naubiomech/OpenExo/README.md

# Teensy Nano Board

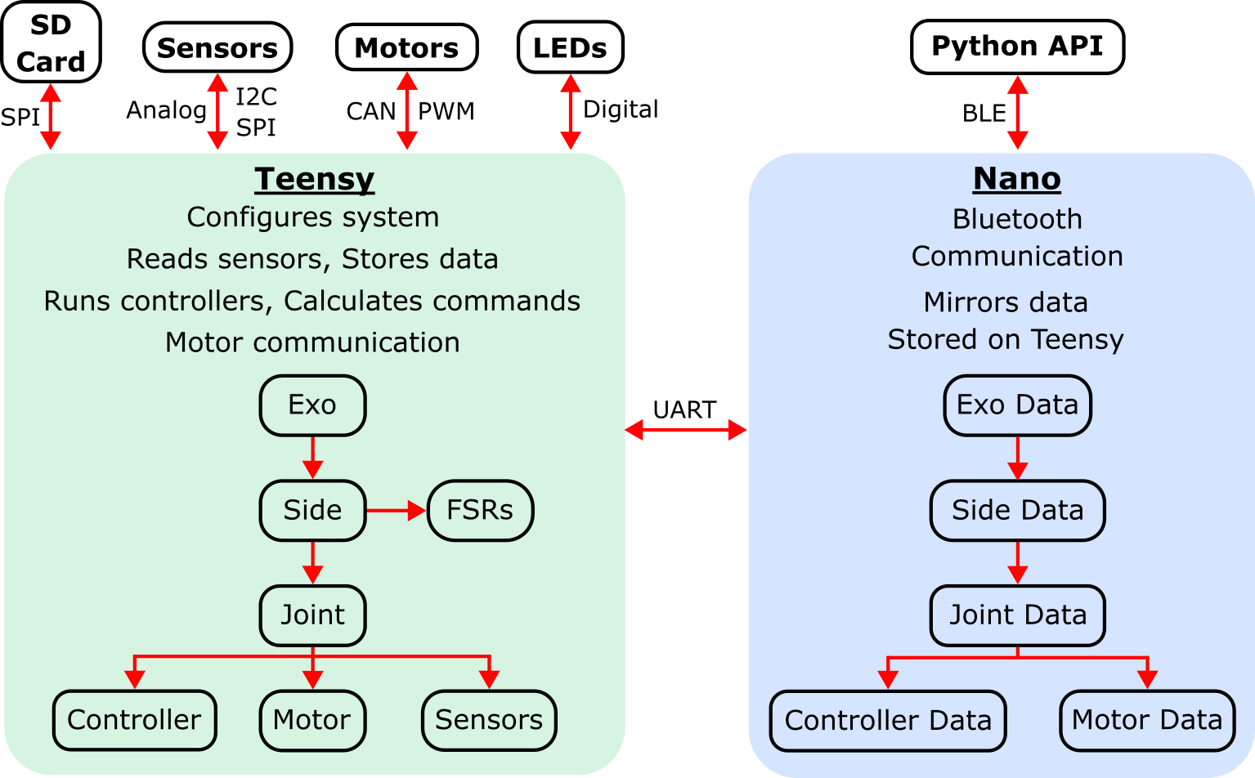
[picture p1: Documentation/Figures/Code_Structure.png]
Diagram


This code uses two microcontrollers to control wearable robots. In order to
build the and flash the codebase check [here](Documentation/BUILD_AND_FLASH.md) and [here](https://github.com/naubiomech/TeensyNanoExoCode/blob/main/Documentation/README.md#how-to-deploy). If you would like to
contribute check [here](CONTRIBUTING.md) for more details. 
 
Check out the [Documentation Folder](/Documentation) for more details and C++ info.

Documentation on the software can be found on our [read the docs page](https://theopenexo.readthedocs.io/en/latest/index.html).

Documentation on the hardware can be found on our [wiki](https://wiki.theopenexo.org).

Video walkthroughs on getting started and indepth looks at different aspects of the system can be found on the OpenExo [YouTube page](https://www.youtube.com/@TheOpenExo).
