naubiomech/OpenExo/Andriod_App/FinalProject_Part1_Documentation.pdf

Final Project - Part 1

April 7, 2026

Group Members:

Landon Coonrod: Lead Developer (UI/UX design, navigation, Firebase REST API integration, database design, documentation, and architectural decisions)
AI Assistant: Assists with BLE Bluetooth communication, real-time charting,
CSV file handling

Physical Phone Availability:
No, our group needs access to a physical Android phone for testing.

REST API:
We are using Firebase Authentication REST API and Firebase Realtime Database REST API. Firebase Auth handles user login/signup so researchers can have their own accounts and keep their trial data separate. Firebase Realtime Database stores trial logs, settings,
and notes in the cloud so data can be accessed from multiple devices. We chose Firebase because it has a free tier and works well with Android.

I am using AI as my second team member. I handle everything covered in class
(UI screens, REST API integration, database design, MVVM architecture, documentation, UML diagrams). AI assists with the stuff not covered in class like BLE hardware communication, real-time data charting, and CSV export.

Basic UI:
The app has 6 screens:
1. Login Screen: Email/password login and signup screen using Firebase Auth. Has input fields, show/hide password toggle, error messages, and a toggle between login and create account modes.

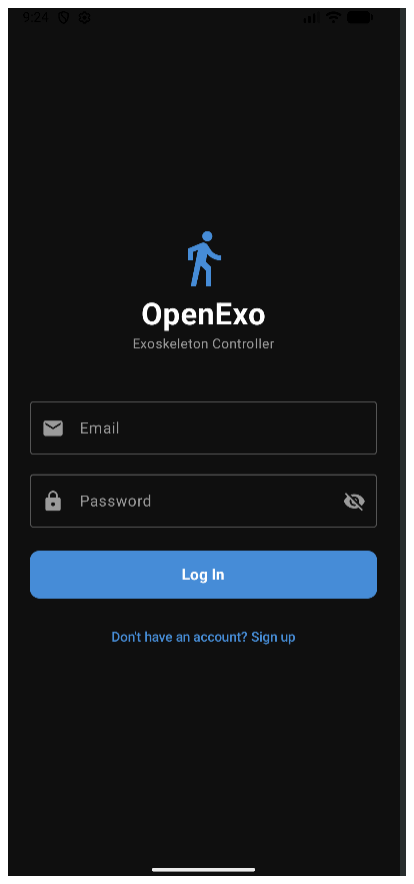
[picture p25: figure]

2. Scan Screen: Home screen where users scan for and connect to OpenExo devices via bluetooth. Has connection status indicator, device list, and buttons for scanning, connecting, calibrating torque, and starting a trial.

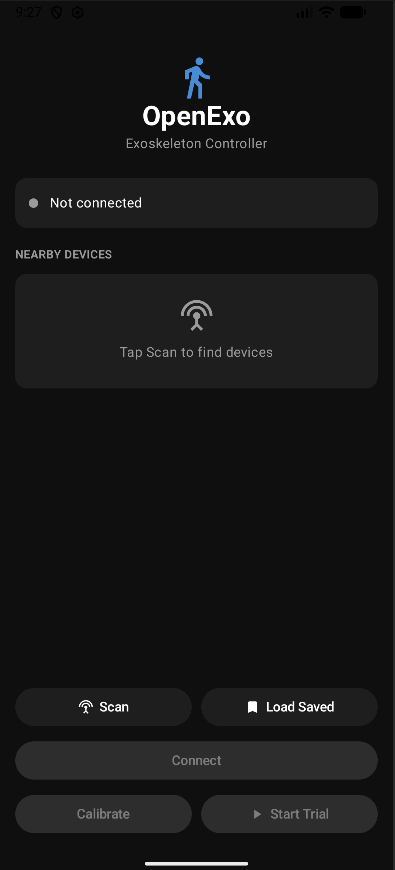
[picture p26: figure]

3. Active Trial Screen: Main trial view with real-time chart placeholders for torque and angle data, battery voltage display, pause/resume and end trial controls, and a list of controller actions like marking trials and updating settings.

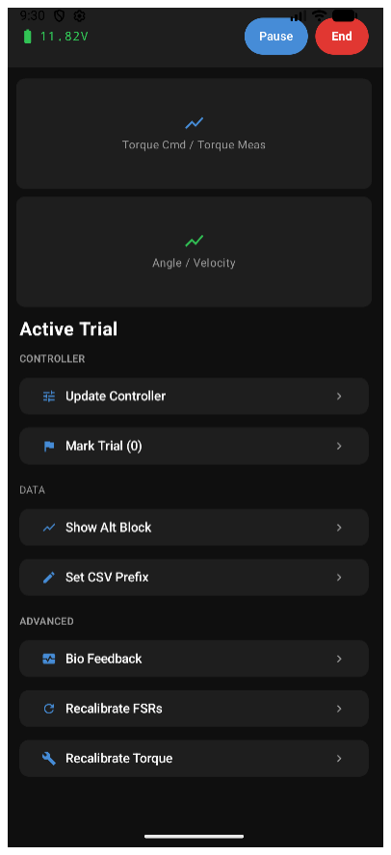
[picture p27: figure]

4. Settings Screen: Controller parameter configuration with an advanced/basic toggle, joint selector dropdown, controller radio buttons, and a numeric value input field
with cancel/apply buttons.

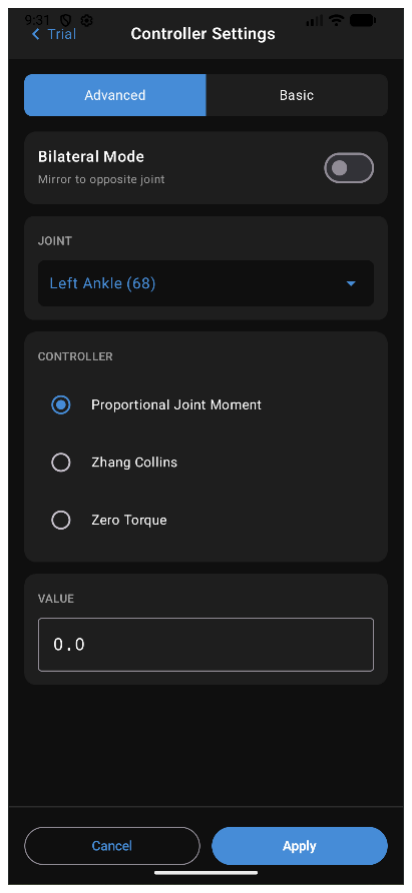
[picture p28: figure]

5. Biofeedback Screen: Displays FSR sensor readings with a large numeric readout, targets reached counter, chart placeholder for real-time FSR signal, target threshold display, leg toggle, and FSR index configuration.

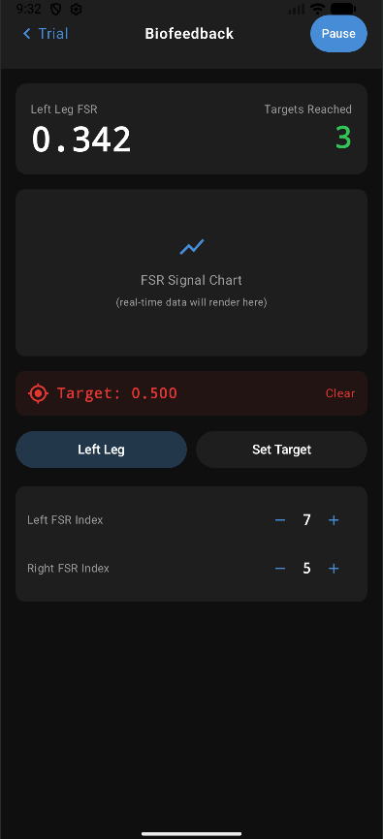
[picture p29: figure]

6. End Trial Screen: Post-trial review screen showing file details (name, size, data points, duration), rename field, trial notes text area, share/export option, and save or discard buttons.

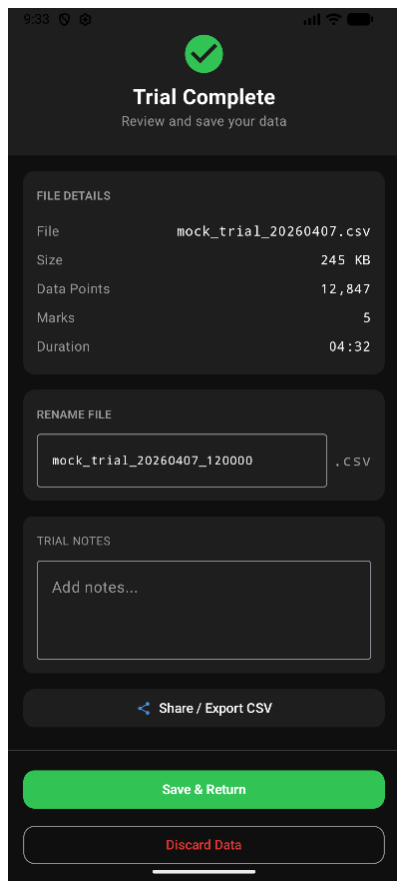
[picture p30: figure]

Tech Stack:
- Kotlin + Jetpack Compose
- Navigation Compose for screen routing
- Material 3 / Material Icons
- Dark theme throughout the app
