naubiomech/OpenExo/Documentation/ReadTheDocs/source/introduction.rst

Introduction
============

Welcome to the OpenExo Software Documentation! This documentation serves as a comprehensive guide to the OpenExo firmware.

Key topics covered in this documentation include:

- `User Guide <https://theopenexo.readthedocs.io/en/latest/User_Guide.html>`__: A concise overview of the coding standards and engineering principles our group follows.
- `First Time Startup <https://theopenexo.readthedocs.io/en/latest/FirstTimeStartup.html>`__: Guide to starting up the exoskeleton and running a controller for the first time. 
- `Installation <https://theopenexo.readthedocs.io/en/latest/installation.html>`__: Step-by-step guidance to set up the software and hardware components.
- `Adding Elements <https://theopenexo.readthedocs.io/en/latest/addingelements.html>`__: Practical examples that show how to extend the platform with new sensors, actuators, and algorithms.
- `Controllers <https://theopenexo.readthedocs.io/en/latest/controllers.html>`__: Reference material and tutorials for implementing ankle and elbow controllers.
- `OpenExo GUI <https://theopenexo.readthedocs.io/en/latest/gui.html>`__:  A walkthrough of our Python-based graphical application for configuring and controlling the exoskeleton.
- `Gamification Template <https://theopenexo.readthedocs.io/en/latest/gamification_template.html>`__: Guidelines and assets for a biofeedback gamification option.
- `Style Guide <https://theopenexo.readthedocs.io/en/latest/StyleGuide.html>`__: Overview of how we maintain our firmware. 
- `Documentation <https://theopenexo.readthedocs.io/en/latest/AddingNewPages.html>`__: Instructions for adding pages, diagrams, and API references to the Read the Docs site

Whether you're a engineer, clinician, or a curious global citizen, we hope this resource helps you explore, learn, and contribute to advancing wearable robotics and rehabilitation technologies.
