naubiomech/OpenExo/Andriod_App/screenshots/active.png

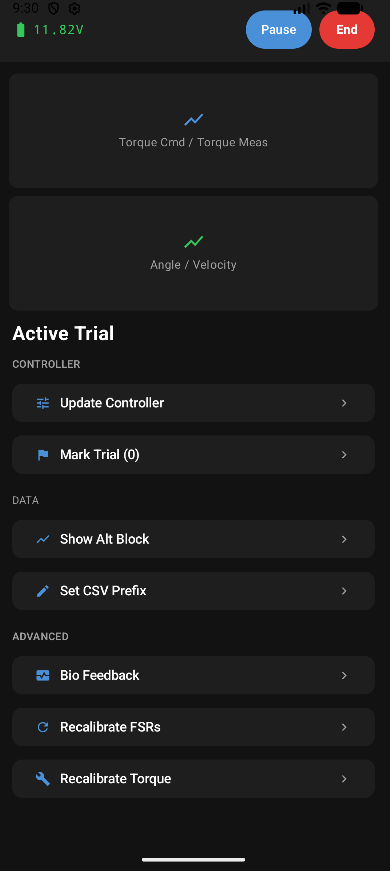
Andriod_App/screenshots/active.png
