naubiomech/OpenExo/Andriod_App/screenshots/endtrial.png

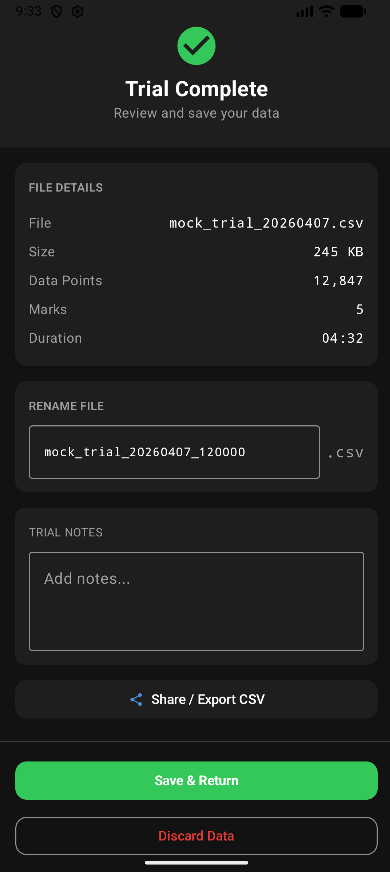
Andriod_App/screenshots/endtrial.png
