naubiomech/OpenExo/Andriod_App/screenshots/login.png

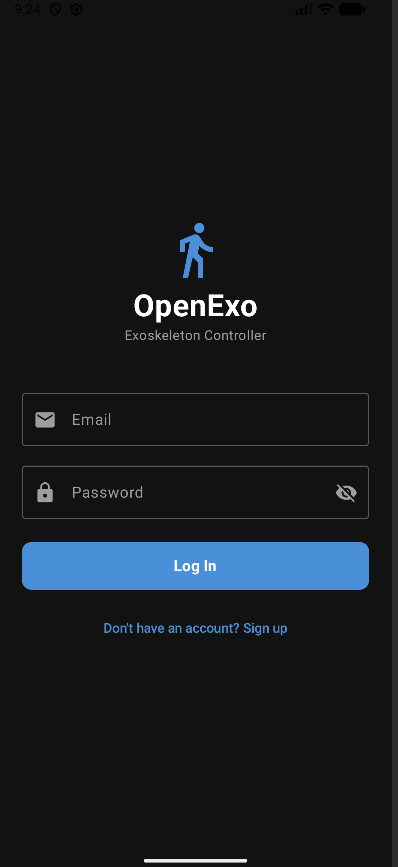
Andriod_App/screenshots/login.png
