naubiomech/OpenExo/Andriod_App/screenshots/settings.png

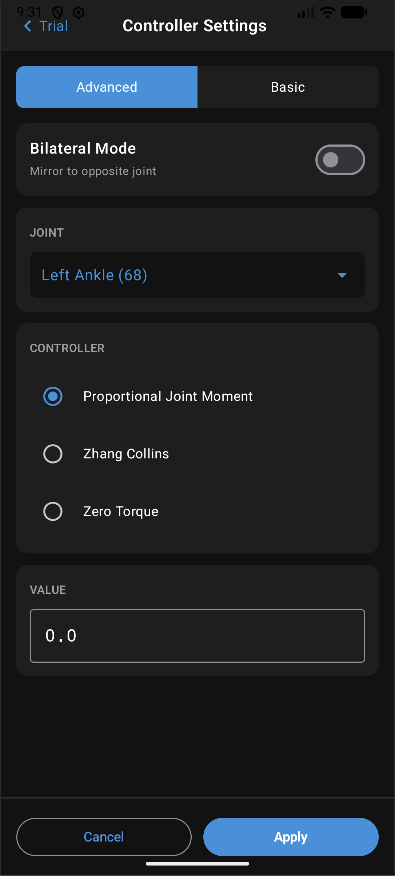
Andriod_App/screenshots/settings.png
