naubiomech/OpenExo/Python_GUI/Resources/Images/OpenExo.png

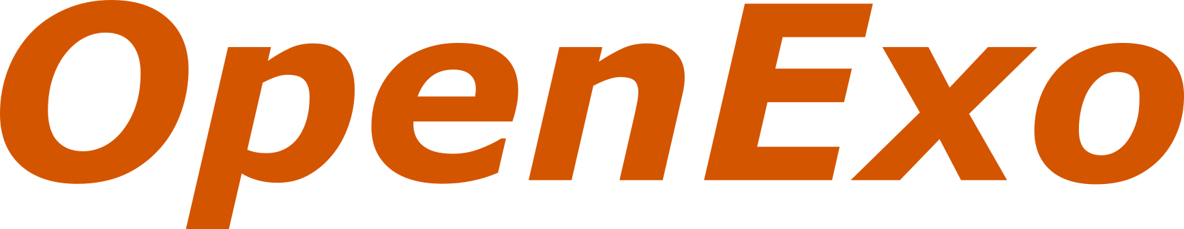
Python_GUI/Resources/Images/OpenExo.png
