naubiomech/OpenExo/Python_GUI/Resources/Images/pause.png

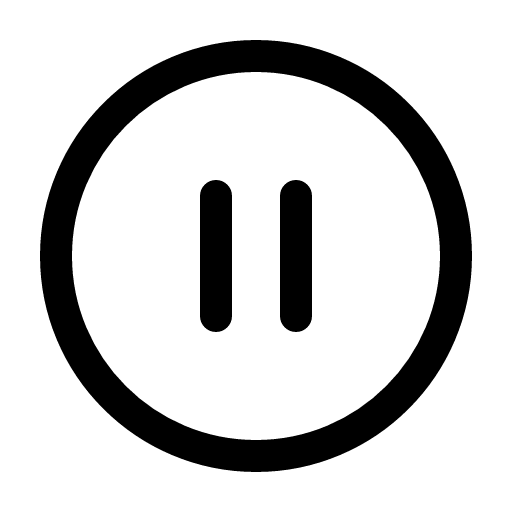
Python_GUI/Resources/Images/pause.png
