naubiomech/OpenExo/Python_GUI/Resources/Images/play.png

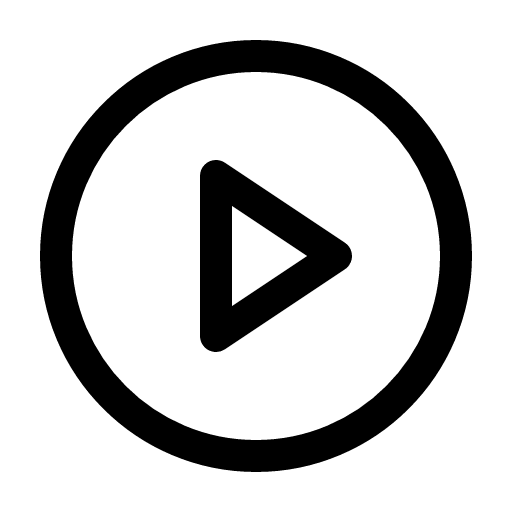
Python_GUI/Resources/Images/play.png
