naubiomech/OpenExo/Hardware/Bowden_Transmission/Large_Cable/Universal Cable Chain Interface/UCCI.STEP

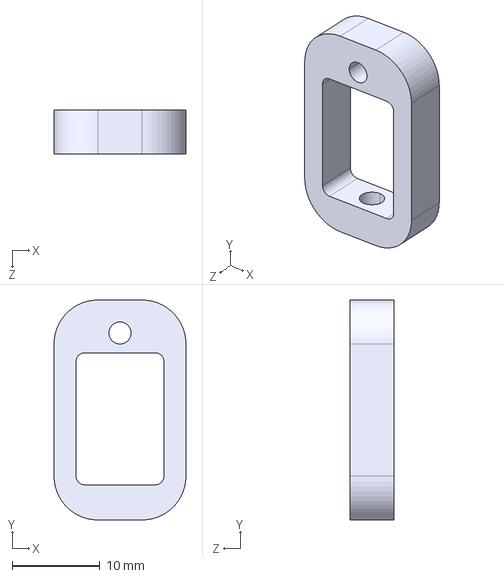
[picture p38: CAD file, 2024-09-13, last stored version]
Hardware/Bowden_Transmission/Large_Cable/Universal Cable Chain Interface/UCCI.STEP
15.0 x 25.0 x 5.00 mm
