naubiomech/OpenExo/Hardware/Bowden_Transmission/Parts/AK60V1.1/3D_Printed_Parts/Heat_Shield (Optional)/ak60v1_1HeatShield.SLDPRT

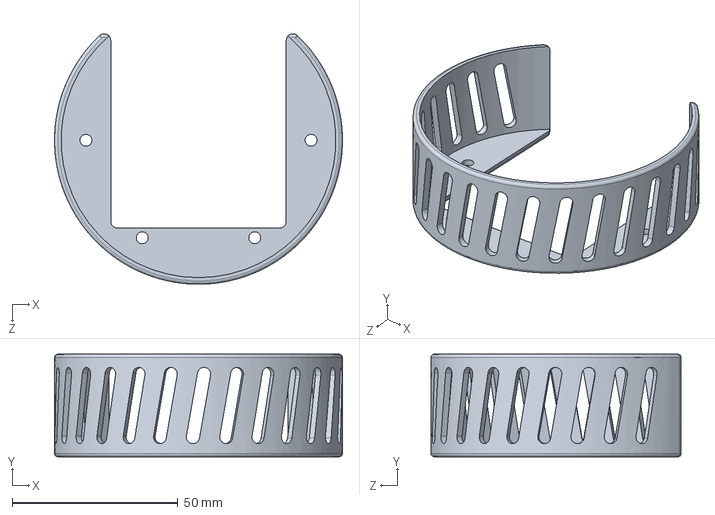
[picture p39: CAD file, 2025-01-06, last stored version]
Hardware/Bowden_Transmission/Parts/AK60V1.1/3D_Printed_Parts/Heat_Shield (Optional)/ak60v1_1HeatShield.SLDPRT
87.0 x 31.0 x 75.7 mm
