naubiomech/OpenExo/Hardware/Bowden_Transmission/Parts/AK60V1.1/3D_Printed_Parts/Strain_Relief_Inserts_TPU.SLDPRT

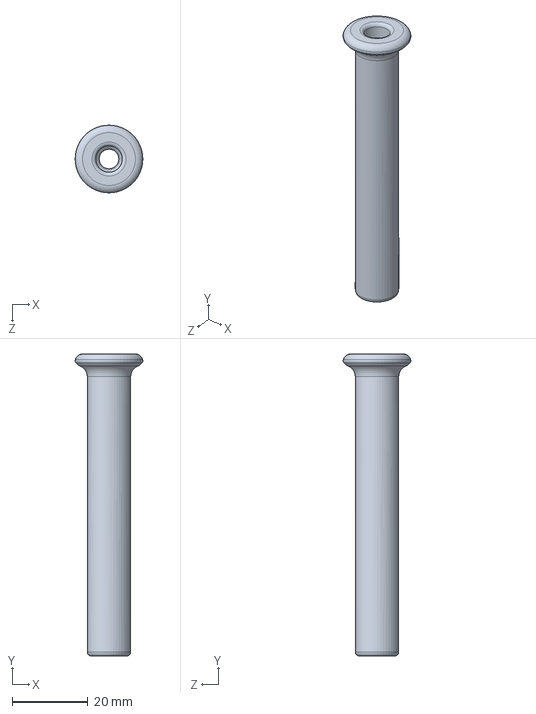
[picture p40: CAD file, 2024-09-13, last stored version]
Hardware/Bowden_Transmission/Parts/AK60V1.1/3D_Printed_Parts/Strain_Relief_Inserts_TPU.SLDPRT
17.9 x 80.0 x 17.9 mm
