naubiomech/OpenExo/Hardware/Bowden_Transmission/Parts/AK60V1.1/Machined_Parts/Sprocket_AK60V1_1.SLDPRT

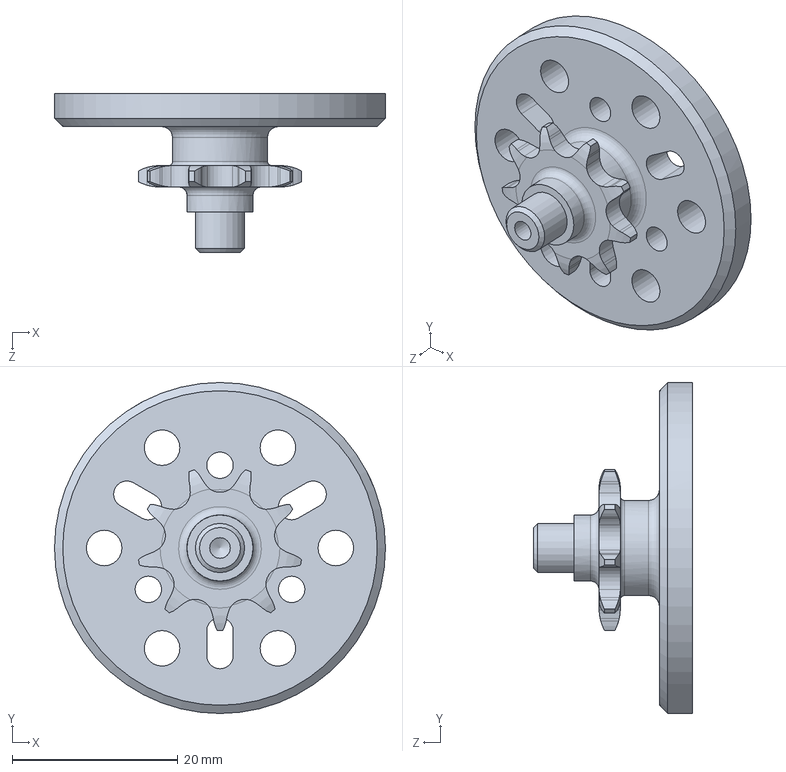
[picture p41: CAD file, 2024-09-13, last stored version]
Hardware/Bowden_Transmission/Parts/AK60V1.1/Machined_Parts/Sprocket_AK60V1_1.SLDPRT
40.0 x 40.0 x 19.2 mm
