naubiomech/OpenExo/Hardware/Bowden_Transmission/Parts/AK80/3D_Printed_Parts/Heat_Shield (Optional)/ak80HeatShield.SLDPRT

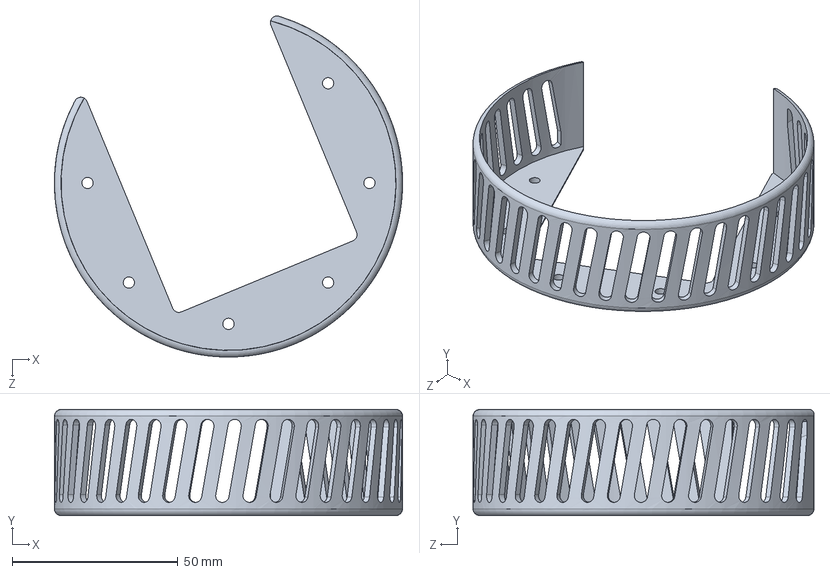
[picture p42: CAD file, 2025-01-06, last stored version]
Hardware/Bowden_Transmission/Parts/AK80/3D_Printed_Parts/Heat_Shield (Optional)/ak80HeatShield.SLDPRT
105.0 x 32.0 x 102.8 mm
