naubiomech/OpenExo/Hardware/Hip_Device/Part Files for 3D Printing/Heat_Shield (Optional)/hipHeatShield.SLDPRT

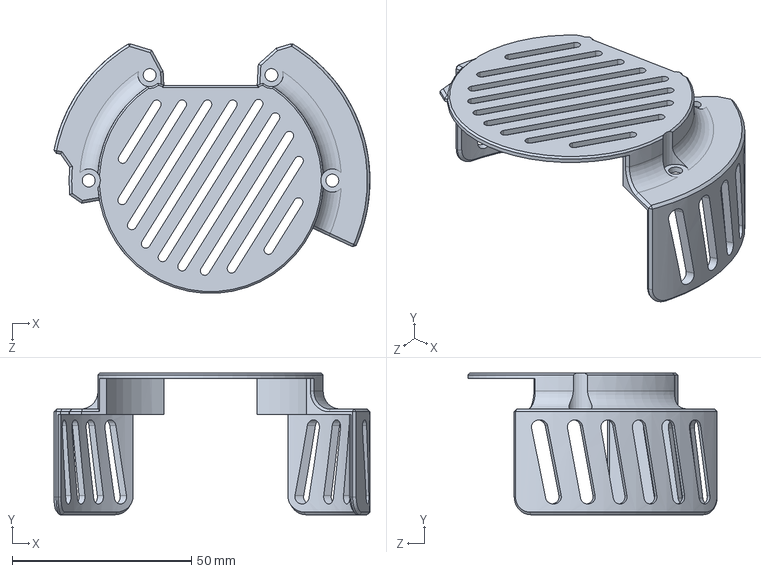
[picture p43: CAD file, 2025-01-06, last stored version]
Hardware/Hip_Device/Part Files for 3D Printing/Heat_Shield (Optional)/hipHeatShield.SLDPRT
88.2 x 39.5 x 69.6 mm
