naubiomech/OpenExo/Hardware/Bowden_Transmission/Parts/AK60V1.1/3D_Printed_Parts/Back_Cover_AK60V1_1(1).SLDPRT

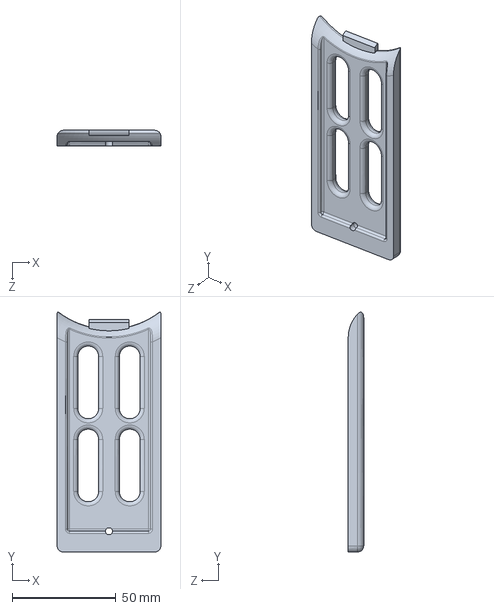
[picture p44: CAD file, 2024-09-13, last stored version]
Hardware/Bowden_Transmission/Parts/AK60V1.1/3D_Printed_Parts/Back_Cover_AK60V1_1(1).SLDPRT
50.0 x 115.7 x 7.50 mm
