naubiomech/OpenExo/(list of files, cad)

Other CAD files:
Hardware/Bowden_Transmission/Large_Cable/Universal Cable Chain Interface/UCCI.SLDDRW
Hardware/Bowden_Transmission/Large_Cable/Universal Cable Chain Interface/UCCI.SLDPRT
Hardware/Bowden_Transmission/Large_Cable/Universal Cable Chain Interface/UCCI.STL
