naubiomech/OpenExo/SDCard/elbowControllers/step.csv

5 | header Size, the first N rows will be ignored, except for this first cells in the first two rows
9 | parameter number, the number of parameters to read per line
 | Parameter list for the Sine controller
 | Parameter order:
Amplitude | Duration | Repetitions | Spacing | PID Flag | P Gain | I Gain | D Gain | Alpha
0 | 0 | 0 | 0 | 0 | 0 | 0 | 0 | 100
