naubiomech/OpenExo/Documentation/ReadTheDocs/source/installation.rst

Installation
============

Overview of the installation process.

.. toctree::
   :maxdepth: 2
   :caption: Installation Subcategories:

   vscode_setup
   BuildAndFlash
