naubiomech/OpenExo/Documentation/ReadTheDocs/source/photos/StartupGuide/BoardsManager.png

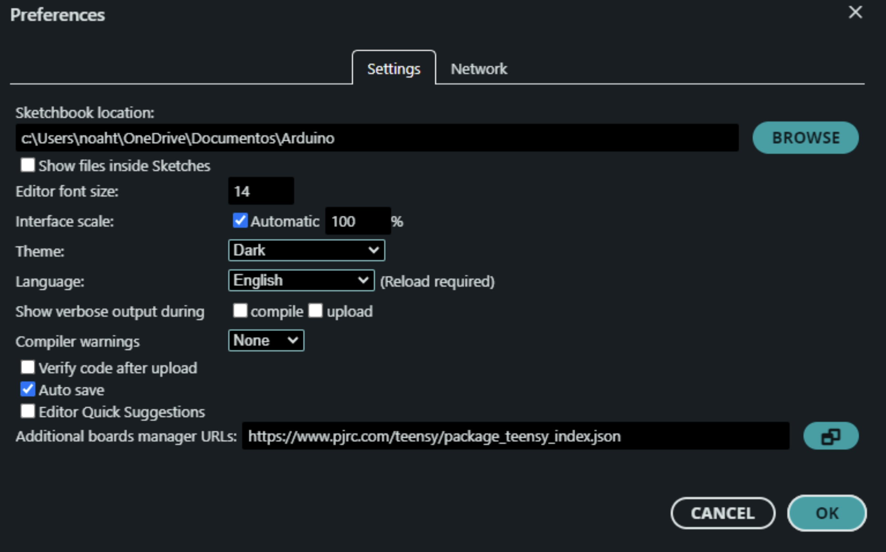
Documentation/ReadTheDocs/source/photos/StartupGuide/BoardsManager.png
