naubiomech/OpenExo/ExoCode/src/Controller.cpp

/*
 * P. Stegall Jan. 2022
*/

#include "Controller.h"
#include "Logger.h"
//#define CONTROLLER_DEBUG          //Uncomment to enable debug statements to be printed to the serial monitor

//Arduino compiles everything in the src folder even if not included so it causes and error for the nano if this is not included.
#if defined(ARDUINO_TEENSY36)  || defined(ARDUINO_TEENSY41) 
#include <math.h>
#include <random>
#include <cmath>

_Controller::_Controller(config_defs::joint_id id, ExoData* exo_data)
{
    _id = id;
    _data = exo_data;
    
    _t_helper = Time_Helper::get_instance();
    _t_helper_context = _t_helper->generate_new_context();
    _t_helper_delta_t = 0;
    _sim_gait_context = _t_helper->generate_new_context();
    _sim_elapsed_us = 0.0f;
    
    //We just need to know the side to point at the right data location so it is only for the constructor
    bool is_left = utils::get_is_left(_id);
    
    #ifdef CONTROLLER_DEBUG
        logger::print(is_left ? "Left " : "Right ");
    #endif 

    _prev_input = 0; 
    _prev_de_dt = 0;
        
    //Set _controller_data to point to the data specific to the controller.
    switch (utils::get_joint_type(_id))
    {
        case (uint8_t)config_defs::joint_id::hip:
            #ifdef CONTROLLER_DEBUG
                logger::print("HIP ");
            #endif
            if (is_left)
            {
                _controller_data = &(exo_data->left_side.hip.controller);
                _joint_data = &(exo_data->left_side.hip);
            }
            else
            {
                _controller_data = &(exo_data->right_side.hip.controller);
                _joint_data = &(exo_data->right_side.hip);
            }
            break;
            
        case (uint8_t)config_defs::joint_id::knee:
            #ifdef CONTROLLER_DEBUG
                logger::print("KNEE ");
            #endif
            if (is_left)
            {
                _controller_data = &(exo_data->left_side.knee.controller);
                _joint_data = &(exo_data->left_side.knee);
            }
            else
            {
                _controller_data = &(exo_data->right_side.knee.controller);
                _joint_data = &(exo_data->right_side.knee);
            }
            break;
        
        case (uint8_t)config_defs::joint_id::ankle:
            #ifdef CONTROLLER_DEBUG
                logger::print("ANKLE ");
            #endif
            if (is_left)
            {
                _controller_data = &(exo_data->left_side.ankle.controller);
                _joint_data = &(exo_data->left_side.ankle);
            }
            else
            {
                _controller_data = &(exo_data->right_side.ankle.controller);
                _joint_data = &(exo_data->right_side.ankle);
            }
            break;
        case (uint8_t)config_defs::joint_id::elbow:
            #ifdef CONTROLLER_DEBUG
                        logger::print("ELBOW ");
            #endif
            if (is_left)
            {
                _controller_data = &(exo_data->left_side.elbow.controller);
                _joint_data = &(exo_data->left_side.elbow);
            }
            else
            {
                _controller_data = &(exo_data->right_side.elbow.controller);
                _joint_data = &(exo_data->right_side.elbow);
            }
            break;
        case (uint8_t)config_defs::joint_id::arm_1:
            #ifdef CONTROLLER_DEBUG
                logger::print("ARM 1 ");
            #endif
            if (is_left)
            {
                _controller_data = &(exo_data->left_side.arm_1.controller);
                _joint_data = &(exo_data->left_side.arm_1);
            }
            else
            {
                _controller_data = &(exo_data->right_side.arm_1.controller);
                _joint_data = &(exo_data->right_side.arm_1);
            }
            break;
        case (uint8_t)config_defs::joint_id::arm_2:
            #ifdef CONTROLLER_DEBUG
                logger::print("ARM 2 ");
            #endif
            if (is_left)
            {
                _controller_data = &(exo_data->left_side.arm_2.controller);
                _joint_data = &(exo_data->left_side.arm_2);
            }
            else
            {
                _controller_data = &(exo_data->right_side.arm_2.controller);
                _joint_data = &(exo_data->right_side.arm_2);
            }
            break;
    }

    #ifdef CONTROLLER_DEBUG
        logger::print("Controller : \n\t_controller_data set \n\t_joint_data set");
    #endif

    //Added a pointer to the side data as most controllers will need to access info specific to their side.
    if (is_left)
    {
        _side_data = &(exo_data->left_side);
    }
    else
    {
        _side_data = &(exo_data->right_side);
    } 

    #ifdef CONTROLLER_DEBUG
        logger::println("\n\t_side_data set");
    #endif
    
    //Set the parameters for cf mfac
    measurements.first = -1;
    measurements.second = 1;
    outputs.first = 0;
    outputs.second = 0;
    phi.first = 2;
    phi.second = 0;
    rho = 0.5;
    lamda = 2;
    etta = 1;
    mu = 1;
    upsilon = 1 / (pow(10, 5));
    phi_1 = phi.first;
}

//****************************************************

void _Controller::reset_integral()
{
    _pid_error_sum = 0;
    _prev_input = 0;
    _prev_de_dt = 0;
    _prev_pid_time = 0;
}

//****************************************************

float _Controller::_cf_mfac(float reference, float current_measurement)         //Compact Form Model Free Adaptive Controller (In-development, not yet employed)
{
    //Calculate k-1 (k_0) delta
    const float du_k0 = outputs.second - outputs.first;

    //Prime the state
    measurements.first = measurements.second;
    outputs.first = outputs.second;
    phi.first = phi.second;
    measurements.second = current_measurement;

    //Calculate k delta
    const float dy_k = measurements.second - measurements.first;

    //Calculate the new psuedo partial derivative
    const float phi_numerator = etta * du_k0 * (dy_k - (phi.first*du_k0));
    const float phi_denominator = mu + (du_k0*du_k0);
    phi.second = phi.first + (phi_numerator/phi_denominator);

    //Calculate the new output
    const float error = reference - measurements.second;
    const float u_numerator = rho * phi.second * error;
    const float u_denominator = lamda + (abs(phi.second) * abs(phi.second));
    outputs.second = outputs.first + (u_numerator/u_denominator);
    return outputs.second;
}

//****************************************************
 
float _Controller::_pid(float cmd, float measurement, float p_gain, float i_gain, float d_gain)
{	
	// Disable pid for torque control if the torque sensor isn't calibrated
	if (_joint_data->torque_offset_reading == 0) {
		Serial.print("\nTorque sensor not calibrated. Closed-loop torque control disabled.");
		return cmd;
	}
    const float expected_us = (1.0f / LOOP_FREQ_HZ) * 1000000.0f;
    const float dt_us = _t_helper->tick(_t_helper_context);
    const bool time_good = (dt_us > 0.0f) && (dt_us <= expected_us * (1.0f + LOOP_TIME_TOLERANCE));
    const float dt_s = dt_us / 1000000.0f;

    //Calculate the difference in the prescribed and measured torque 
    float error_val = cmd - measurement;  

    //If we want to to include the integral term (Note: We generally do not like to use the I gain but we have it here for completeness) 
    if (i_gain != 0)
    {
        if (time_good)
        {
            _pid_error_sum += error_val * dt_s;
        }
    }
    else
    {
        _pid_error_sum = 0;
    }

    //Get the current status of the exskleton 
    uint16_t exo_status = _data->get_status();
    bool active_trial = (exo_status == status_defs::messages::trial_on) || (exo_status == status_defs::messages::fsr_calibration) || (exo_status == status_defs::messages::fsr_refinement);

    //Reset the integral term if the user pauses the trial or we are no longer in an active trial
    if (_data->user_paused || !active_trial)
    {
        _pid_error_sum = 0;
    }

    //Initialize the derivative of the error 
    float de_dt = 0;

    //Calculate the derivative of the error
    if (time_good && dt_s > 0.0f)
    {
        de_dt = -(measurement - _prev_input) / dt_s;
        _prev_de_dt = de_dt;
    }
    else 
    {
        de_dt = 0;
    }

    //Set the previous times for the next loop through the controller
    _prev_input = measurement;

    //Calculate the individual P,I,and D Terms
    float p = p_gain * error_val;  
    float i = i_gain * _pid_error_sum; 
    float d = d_gain * de_dt; 

    //Return the summed PID
    return p + i + d;

}

//****************************************************

float _Controller::_get_percent_gait(bool simulate)
{
    if (!simulate)
    {
        return _side_data->percent_stance;
    }

    _sim_elapsed_us += _t_helper->tick(_sim_gait_context);
    return fmodf(_sim_elapsed_us, 1000000.0f) / 1000000.0f * 100.0f;
}

//****************************************************
 
float _Controller::_pjmc_generic(float current_fsr, float fsr_threshold, float setpoint_positive, float setpoint_negative)
{
	if (fsr_threshold == 1)
    {
		return 0;               //fsr_threshold shouldn't be set to 1
	}

	float slope = (setpoint_positive - setpoint_negative)/(1 - fsr_threshold);

	float prescribed_val = setpoint_positive - slope * (current_fsr - fsr_threshold);

	return prescribed_val;      //Note: This prescribed value is not capped
}

//****************************************************

ZeroTorque::ZeroTorque(config_defs::joint_id id, ExoData* exo_data)
: _Controller(id, exo_data)
{
    
    #ifdef CONTROLLER_DEBUG
        logger::println("ZeroTorque::Constructor");
    #endif
    
}

float ZeroTorque::calc_motor_cmd()
{
    //Set feed-forward command to zero
    float cmd_ff = 0;

    //Set the motor command to the feed-forward command
    float cmd = cmd_ff;
    
    //Add the PID contribution to the motor command if desired 
    if (_controller_data->parameters[controller_defs::zero_torque::use_pid_idx])
    {
        cmd = cmd_ff + _pid(cmd_ff, _joint_data->torque_reading, _controller_data->parameters[controller_defs::zero_torque::p_gain_idx], _controller_data->parameters[controller_defs::zero_torque::i_gain_idx], _controller_data->parameters[controller_defs::zero_torque::d_gain_idx]);
    }

    //Set the feed-forward setpoint to the feed-forward command
    _controller_data->ff_setpoint = cmd_ff;

    //Set the desired torque for plotting
    _controller_data->desired_torque = cmd_ff;

    //Send the motor command
    return cmd;

}

//****************************************************

TREC::TREC(config_defs::joint_id id, ExoData* exo_data)
: _Controller(id, exo_data)
{
    #ifdef CONTROLLER_DEBUG
        logger::println("TREC::Constructor");
    #endif
}

void TREC::_update_reference_angles(SideData* side_data, ControllerData* controller_data, float percent_grf, float percent_grf_heel)
{
    //When the percent_grf passes the threshold, update the reference angle
    const float threshold = controller_data->parameters[controller_defs::trec::timing_threshold]/100;
    const bool should_update = (percent_grf > controller_data->toeFsrThreshold) && !controller_data->reference_angle_updated;
    const bool should_capture_level_entrance = side_data->do_calibration_refinement_toe_fsr && !side_data->do_calibration_toe_fsr;
    const bool should_reset_level_entrance_angle = controller_data->prev_calibrate_level_entrance < should_capture_level_entrance;

    if (should_reset_level_entrance_angle)
    {
        controller_data->level_entrance_angle = 0.5;
    }

    if (should_update)
    {
        if (should_capture_level_entrance)
        {
            controller_data->level_entrance_angle = utils::ewma(side_data->ankle.joint_position, controller_data->level_entrance_angle, controller_data->cal_level_entrance_angle_alpha);
        }

        controller_data->reference_angle_updated = true;
        controller_data->reference_angle = side_data->ankle.joint_position;
        
        //controller_data->reference_angle_offset = side_data->ankle.joint_global_angle;
    }

    //When the percent_grf drops below the threshold, reset the reference angle updated flag and expire the reference angle
    const bool should_reset = (percent_grf < controller_data->toeFsrThreshold) && controller_data->reference_angle_updated;
    
    if (should_reset)
    {
        controller_data->reference_angle_updated = false;
        controller_data->reference_angle = 0;
        controller_data->reference_angle_offset = 0;
    }

    controller_data->prev_calibrate_level_entrance = should_capture_level_entrance;
}

void TREC::_capture_neutral_angle(SideData* side_data, ControllerData* controller_data)
{
    //On the start of torque calibration reset the neutral angle
    if (controller_data->prev_calibrate_trq_sensor < side_data->ankle.calibrate_torque_sensor)
    {
        controller_data->neutral_angle = side_data->ankle.joint_position;
    }

    if (side_data->ankle.calibrate_torque_sensor) 
    {
        //Update the neutral angle with an ema filter
        controller_data->neutral_angle = utils::ewma(side_data->ankle.joint_position, controller_data->neutral_angle, controller_data->cal_neutral_angle_alpha);
    }

    controller_data->prev_calibrate_trq_sensor = side_data->ankle.calibrate_torque_sensor;
}

void TREC::_grf_threshold_dynamic_tuner(SideData* side_data, ControllerData* controller_data, float threshold, float percent_grf_heel)
{
	//If it's swing phase, set wait4HiHeelFSR to True, and increase the toeFSR threshold; when wait4HiHeelFSR is true and heelFSR > a pre-defined threshold, reduce the toeFSR threshold; when it's stance phase, set wait4HiHeelFSR to False
	if (!side_data->toe_stance)
    {
		controller_data->wait4HiHeelFSR = true;
	}
	else
    {
		controller_data->wait4HiHeelFSR = false;
		controller_data->toeFsrThreshold = threshold*0.01;
	}
	if (controller_data->wait4HiHeelFSR) 
    {
		if (percent_grf_heel > threshold) 
        {
			controller_data->toeFsrThreshold = threshold*0.1;
		}
		else 
        {
			controller_data->toeFsrThreshold = threshold;
		}
	}
}

void TREC::_plantar_setpoint_adjuster(SideData* side_data, ControllerData* controller_data, float pjmcSpringDamper)
{
	if(_side_data->toe_stance) 
    {	
		//Update peak values
		_controller_data->maxPjmcSpringDamper = max(_controller_data->maxPjmcSpringDamper, pjmcSpringDamper);
		_controller_data->wasStance = true;
	}
	else 
    {
		if (_controller_data->wasStance) 
        {
			_controller_data->prevMaxPjmcSpringDamper = _controller_data->maxPjmcSpringDamper;
			_controller_data->maxPjmcSpringDamper = 0;
			
			if (_controller_data->prevMaxPjmcSpringDamper < _controller_data->parameters[controller_defs::trec::plantar_scaling]) 
            {
			_controller_data->setpoint2use ++;
			}
			else 
            {
				_controller_data->setpoint2use --;
			}

			_controller_data->setpoint2use = min(_controller_data->setpoint2use, 35);
			_controller_data->setpoint2use = max(_controller_data->setpoint2use, 0);
			_controller_data->wasStance = false;
		}
	}
	if (_controller_data->prevMaxPjmcSpringDamper == 0) 
    {
		_controller_data->setpoint2use = _controller_data->parameters[controller_defs::trec::plantar_scaling];
	}
}


float TREC::calc_motor_cmd()
{
    #ifdef CONTROLLER_DEBUG
        logger::println("TREC::calc_motor_cmd : start");
    #endif

    static const float sigmoid_exp_scalar{50.0f};

    //Calculate Generic Contribution
	float plantar_setpoint = 0;

    if (_controller_data->parameters[controller_defs::trec::turn_on_peak_limiter]) 
    {
		plantar_setpoint = _controller_data->setpoint2use;
	}
	else 
    {
		plantar_setpoint = _controller_data->parameters[controller_defs::trec::plantar_scaling];
		_controller_data->setpoint2use = plantar_setpoint;
	}

	const float dorsi_setpoint = -_controller_data->parameters[controller_defs::trec::dorsi_scaling];
    const float threshold = _controller_data->parameters[controller_defs::trec::timing_threshold]/100;
    const float percent_grf = min(_side_data->toe_fsr, 1);
	const float percent_grf_heel = min(_side_data->heel_fsr, 1);
    const float slope = (plantar_setpoint - dorsi_setpoint)/(1 - threshold);
    const float generic = max(((slope*(percent_grf - threshold)) + dorsi_setpoint), dorsi_setpoint);                    //Stateless "PJMC" stateless
	_controller_data->stateless_pjmc_term = generic;

    //Assistive Contribution (a.k.a: Suspension; this term consists of a "Spring term" and a "Damper term" as the suspension)
    _capture_neutral_angle(_side_data, _controller_data);
	_grf_threshold_dynamic_tuner(_side_data, _controller_data, threshold, percent_grf_heel);
    _update_reference_angles(_side_data, _controller_data, percent_grf, percent_grf_heel);   //When current toe FSR > set threshold, use the current ankle angle as the "reference angle"
    const float k = 0.01 * _controller_data->parameters[controller_defs::trec::spring_stiffness];
    const float b = 0.01 * _controller_data->parameters[controller_defs::trec::damping];
    const float equilibrium_angle_offset = _controller_data->parameters[controller_defs::trec::neutral_angle]/100;
    const float deviation_from_level = (_controller_data->reference_angle - _controller_data->level_entrance_angle);
    const float delta = _controller_data->reference_angle + deviation_from_level - _side_data->ankle.joint_position + equilibrium_angle_offset;//describes the amount of dorsi flexion since toe FSR > set threshold (negative at more plantarflexed angles)
    const float assistive = max(k*delta - b*_side_data->ankle.joint_velocity, 0);//Dorsi velocity: Negative

    //Use a tuned sigmoid to squelch the spring output during the 'swing' phase
    const float squelch_offset = -(1.5*_controller_data->toeFsrThreshold);                                                                                  //1.5 ensures that the spring activates after the new angle is captured
    const float grf_squelch_multiplier = (exp(sigmoid_exp_scalar*(percent_grf+squelch_offset))) / (exp(sigmoid_exp_scalar*(percent_grf+squelch_offset))+1);
    const float squelched_supportive_term = assistive*grf_squelch_multiplier;                                                                               //Finalized suspension term
    
    //Low pass the squelched supportive term
    _controller_data->filtered_squelched_supportive_term = utils::ewma(squelched_supportive_term, _controller_data->filtered_squelched_supportive_term, 0.075);

    //Propulsive Contribution
    const float kProp = 0.01 * _controller_data->parameters[controller_defs::trec::propulsive_gain];
    const float saturated_velocity = _side_data->ankle.joint_velocity > 0 ? _side_data->ankle.joint_velocity:0;
    const float propulsive = kProp*saturated_velocity;

    //Use a symmetric sigmoid to squelch the propulsive term
    const float propulsive_squelch_offset = -1.1 + threshold;
    const float propulsive_grf_squelch_multiplier = (exp(sigmoid_exp_scalar*(percent_grf+propulsive_squelch_offset))) / (exp(sigmoid_exp_scalar*(percent_grf+propulsive_squelch_offset))+1);
    const float squelched_propulsive_term = propulsive*propulsive_grf_squelch_multiplier;
    
	//PJMC reducer
	if (_controller_data->parameters[controller_defs::trec::turn_on_peak_limiter]) 
    {
		_plantar_setpoint_adjuster(_side_data, _controller_data, _controller_data->filtered_squelched_supportive_term+generic);
	}
	
    //Sum for ff
    const float cmd_ff = -(_controller_data->filtered_squelched_supportive_term+generic+squelched_propulsive_term); //According to the new motor command direction definitions, at the ankle, positive for dorsi, and negative for plantar.

    //Low pass filter on torque_reading
    const float torque = _joint_data->torque_reading;
    const float alpha = 0.5;
    _controller_data->filtered_torque_reading = utils::ewma(torque, _controller_data->filtered_torque_reading, alpha);

    //Close the loop
    float cmd = _pid(cmd_ff, _controller_data->filtered_torque_reading, _controller_data->parameters[controller_defs::trec::kp], 0, _controller_data->parameters[controller_defs::trec::kd]);
			
    //Satuarte command to prevent if from going beyond desired limits of torque    
	cmd = min(cmd, cmd_ff + 35);
	cmd = max(cmd, cmd_ff - 35);
	
    //Update plotting variables
    _controller_data->ff_setpoint = cmd_ff;
	_controller_data->setpoint = cmd;
    _controller_data->filtered_setpoint = squelched_propulsive_term;

    //Set the desired torque for plotting
    _controller_data->desired_torque = _controller_data->filtered_setpoint;

    #ifdef CONTROLLER_DEBUG
        logger::println("TREC::calc_motor_cmd : stop");
    #endif

    return cmd;
}

//****************************************************

ProportionalJointMoment::ProportionalJointMoment(config_defs::joint_id id, ExoData* exo_data)
: _Controller(id, exo_data)
{
    #ifdef CONTROLLER_DEBUG
        logger::println("ProportionalJointMoment::Constructor");
    #endif

    /* Set FSR thresholds to engage controller -> Tells it foot is on the ground*/
    _stance_thresholds_left.first = exo_data->left_side.toe_fsr_lower_threshold;
    _stance_thresholds_left.second = exo_data->left_side.toe_fsr_upper_threshold;
    _stance_thresholds_right.first = exo_data->right_side.toe_fsr_lower_threshold;
    _stance_thresholds_right.second = exo_data->right_side.toe_fsr_upper_threshold;
}

float ProportionalJointMoment::calc_motor_cmd()
{
	
    #ifdef CONTROLLER_DEBUG
        logger::println("ProportionalJointMoment::calc_motor_cmd : start");
    #endif

    float cmd_ff = 0;

    /* If the toe is on the ground, calculate the feed-forward command */
    if (_side_data->toe_stance) 
    {
        /* Scale the fsr values so the controller outputs zero feed forward when the FSR value is at the threshold */ 
        float threshold = _side_data->toe_fsr_upper_threshold;       /* Get the upper threshold for the FSR to be considered in stance */
        float fsr = min(_side_data->toe_fsr, 1.2);                   /* Stores a saturated FSR signal from the device, saturates in order to avoid producing a large torque. */
        float scaled_fsr = (fsr - threshold) / (1 - threshold);      /* Re-scales FSR signal */

        /* Calculate FeedForward Command */
        cmd_ff = (scaled_fsr) * _controller_data->parameters[controller_defs::proportional_joint_moment::stance_max_idx];          
            
        /* Saturates Command so that it never is opposite of intent (e.g., going into resistance when wanting assistance) */
        cmd_ff = max(0, cmd_ff);
        
        /* Sets to Assistance or Resistance Based on Controller Parameter Flag */
        cmd_ff = -1 * cmd_ff * (_controller_data->parameters[controller_defs::proportional_joint_moment::is_assitance_idx] ? 1 : -1);
    }
    else /* If the foot is not on the ground, calculate the swing phase command. */
    {
        /* Sets the Assistance to a Constant, user defined torque. */
        cmd_ff = _controller_data->parameters[controller_defs::proportional_joint_moment::swing_max_idx];
    }

    /* Low-Pass Filter Measured Torque */
	const float torque = _joint_data->torque_reading;
    const float alpha = (_controller_data->parameters[controller_defs::proportional_joint_moment::torque_alpha_idx] != 0) ? _controller_data->parameters[controller_defs::proportional_joint_moment::torque_alpha_idx] : 0.5;
    _controller_data->filtered_torque_reading = utils::ewma(torque, _controller_data->filtered_torque_reading, alpha); 

    /* Find the maximum measured torque and maximum setpoint during stance */
    if (_side_data->toe_stance) 
    {
        /* Store the current command and measured torque into set variables */
		const float new_torque = _controller_data->filtered_torque_reading;
		const float new_ff = cmd_ff;
		
        /* Compares to previous maxiums during this step and overwrights those variables if current is larger. */
        _controller_data->max_measured = (_controller_data->max_measured < new_torque) ? new_torque : _controller_data->max_measured;
        _controller_data->max_setpoint = (_controller_data->max_setpoint < new_ff) ? new_ff : _controller_data->max_setpoint;
    }

    /* Set previous max values on rising edge */
    if (_side_data->ground_strike) /* If a ground strike is detected */
    {
        /* Set the previous maximums to the max measured from the previous step, reset those variables to zero. */
        _controller_data->prev_max_measured = _controller_data->max_measured;
        _controller_data->prev_max_setpoint = _controller_data->max_setpoint;
        _controller_data->max_measured = 0;
        _controller_data->max_setpoint = 0;

        /* Caluculate the Kf (velocity feed-forward gain) for this step */
        if ((_controller_data->prev_max_measured > 0.0f) && (_controller_data->parameters[controller_defs::proportional_joint_moment::stance_max_idx] != 0.0f)) /* If the previous maximum was not zero and the controller maximum is not zero. */
        {
            /* Kf is the last set Kf + the ratio of the previous steps max setpoint to the previous steps max measured normalized by direction. */
            _controller_data->kf = _controller_data->kf + ((_controller_data->prev_max_setpoint/_controller_data->prev_max_measured) - 1);

            /* Contrains the Kf to be within 0.75 - 1.25 */
            _controller_data->kf = min(1.25, _controller_data->kf);
            _controller_data->kf = max(0.75, _controller_data->kf);
        }
    }

    /* Filters the Setpoint */
    _controller_data->filtered_setpoint = utils::ewma(cmd_ff, _controller_data->filtered_setpoint, 1);
    _controller_data->ff_setpoint = _controller_data->filtered_setpoint;

    /* Add the PID contribution to the feed forward command */
    float cmd = 0;
    float kf_cmd = (_side_data->toe_stance) ? (_controller_data->kf * _controller_data->filtered_setpoint) : _controller_data->filtered_setpoint;

    /* If the PID flag is enalbed, do PID control, otherwise just send feed-forward command. */
    if (_controller_data->parameters[controller_defs::proportional_joint_moment::use_pid_idx])
    {
        // --------------------------- Gain scheduling (optional) ------------------------------
        
        // Defaults to nominal gains if gain scheduling is not enabled
        float kp_use = _controller_data->parameters[controller_defs::proportional_joint_moment::p_gain_idx];
        float ki_use = _controller_data->parameters[controller_defs::proportional_joint_moment::i_gain_idx];
        float kd_use = _controller_data->parameters[controller_defs::proportional_joint_moment::d_gain_idx];

        const bool gain_sched_enabled =
            (_controller_data->parameters[controller_defs::proportional_joint_moment::GS_Flag] > 0.5f);

        if (gain_sched_enabled)
        {
            // Conditions for "near zero" gains:
            // - setpoint is between +/- 3.5 Nm
            // - measured torque is within +/- 3.5 Nm of setpoint
            const float ZERO_BAND_NM = 3.5f;
            const bool near_zero_setpoint = (fabsf(_controller_data->filtered_setpoint) < 4);
            const bool near_zero_measured  = (fabsf(_controller_data->filtered_torque_reading) <= ZERO_BAND_NM);

            if (near_zero_setpoint && near_zero_measured)
            {
                kp_use = _controller_data->parameters[controller_defs::proportional_joint_moment::kp_zero];
                ki_use = _controller_data->parameters[controller_defs::proportional_joint_moment::ki_zero];
                kd_use = _controller_data->parameters[controller_defs::proportional_joint_moment::kd_zero];
    
            }
            else
            {
                kp_use = _controller_data->parameters[controller_defs::proportional_joint_moment::p_gain_idx];
                ki_use = _controller_data->parameters[controller_defs::proportional_joint_moment::i_gain_idx];
                kd_use = _controller_data->parameters[controller_defs::proportional_joint_moment::d_gain_idx];
            }
            
        } // End of gain scheduling

        // PID on Motor Command
        cmd =  _pid(_controller_data->filtered_setpoint,
                            _controller_data->filtered_torque_reading,
                            kp_use,
                            ki_use,
                            kd_use);
			
    } // End of PID flag check
    else
    {
        cmd = cmd_ff;
    }
    
    /* Filter the commnad being sent to the motor. */
    _controller_data->filtered_cmd = utils::ewma(cmd, _controller_data->filtered_cmd, 1);

    //Set the desired torque for plotting
    _controller_data->desired_torque = _controller_data->filtered_setpoint;

    /* Send the motor the command. */
    return _controller_data->filtered_cmd;
}

//****************************************************

ZhangCollins::ZhangCollins(config_defs::joint_id id, ExoData* exo_data)
: _Controller(id, exo_data)
{
    #ifdef CONTROLLER_DEBUG
        logger::println("ZhangCollins::Constructor");
    #endif

        torque_cmd = 0;
		cmd = 0;

};

float ZhangCollins::calc_motor_cmd()
{
    
    //Calculates Percent Gait
    float percent_gait = _get_percent_gait(_controller_data->parameters[controller_defs::zhang_collins::sim_gait_idx] > 0.0f);
			
    //Pull in user defined parameter values
    float peak_torque_Nm = _controller_data->parameters[controller_defs::zhang_collins::torque_idx];
    float peak_time = _controller_data->parameters[controller_defs::zhang_collins::peak_time_idx];
    float rise_time = _controller_data->parameters[controller_defs::zhang_collins::rise_time_idx];
    float fall_time = _controller_data->parameters[controller_defs::zhang_collins::fall_time_idx];

    //Calculates Nodes for Spline Generation
    float node1 = peak_time - rise_time;
    float node2 = peak_time;
    float node3 = peak_time + fall_time;

    //Calculates Torque Command
    torque_cmd = -1* _spline_generation(node1, node2, node3, peak_torque_Nm, percent_gait);
    
    //Sets the feed-forward setpoint to the desired command
    _controller_data->ff_setpoint = torque_cmd;
    
    //Filters the torque
    _controller_data->filtered_torque_reading = utils::ewma(_joint_data->torque_reading, _controller_data->filtered_torque_reading, 0.5);

    //Adds PID Control if desired 
	if (_controller_data->parameters[controller_defs::zhang_collins::use_pid_idx])
	{
		cmd = torque_cmd + _pid(torque_cmd, _controller_data->filtered_torque_reading, _controller_data->parameters[controller_defs::zhang_collins::p_gain_idx], _controller_data->parameters[controller_defs::zhang_collins::i_gain_idx], _controller_data->parameters[controller_defs::zhang_collins::d_gain_idx]);
	}
	else
	{
		cmd = torque_cmd;
	}

    //Sets previous command for next loop of controller
	_controller_data->previous_cmd = cmd;
	
    //Sets the desired torque for plotting
    _controller_data->desired_torque = torque_cmd;

    return cmd;
};

float ZhangCollins::_spline_generation(float node1, float node2, float node3, float torque_magnitude, float percent_gait)
{
    float u;

    float x[3] = { node1, node2, node3 };
    float y[3] = { 0, torque_magnitude, 0 };

    float h[2] = { (x[1] - x[0]), (x[2] - x[1]) };
    float delta[2] = { ((y[1] - y[0]) / h[0]), ((y[2] - y[1]) / h[1]) };

    float dy[3] = { 0, 0, ((3 * delta[1]) / 2) };

    if (percent_gait < x[0] || percent_gait > x[2])
    {
        u = 0;
    }
    else
    {
        int k = -1;
        if (percent_gait >= x[0] && percent_gait < (x[1]))
        {
            k = 0;
        }
        else if (percent_gait >= x[1] && percent_gait < x[2])
        {
            k = 1;
        }

        float a = delta[k];
        float b = (a - dy[k]) / h[k];
        float c = (dy[k + 1] - a) / h[k];
        float d = (c - b) / h[k];

        u = y[k] + (percent_gait - x[k]) * (dy[k] + (percent_gait - x[k]) * (b + (percent_gait - x[k + 1]) * d));
    }

    return u;
};


//****************************************************

Spline::Spline(config_defs::joint_id id, ExoData* exo_data)
: _Controller(id, exo_data)
{
    #ifdef CONTROLLER_DEBUG
        logger::println("Spline::Constructor");
    #endif
};

float Spline::calc_motor_cmd()
{
    const bool simulate_gait = _controller_data->parameters[controller_defs::spline::sim_gait_idx] > 0.0f;
    const bool use_percent_gait = _controller_data->parameters[controller_defs::spline::use_percent_gait_idx] > 0.0f;
    float percent_gait = 0.0f;
    if (simulate_gait)
    {
        percent_gait = _get_percent_gait(true);
    }
    else
    {
        percent_gait = use_percent_gait ? _side_data->percent_gait : _side_data->percent_stance;
    }

    float x[5] =
    {
        _controller_data->parameters[controller_defs::spline::node1_x_idx],
        _controller_data->parameters[controller_defs::spline::node2_x_idx],
        _controller_data->parameters[controller_defs::spline::node3_x_idx],
        _controller_data->parameters[controller_defs::spline::node4_x_idx],
        _controller_data->parameters[controller_defs::spline::node5_x_idx],
    };

    float y[5] =
    {
        _controller_data->parameters[controller_defs::spline::node1_y_idx],
        _controller_data->parameters[controller_defs::spline::node2_y_idx],
        _controller_data->parameters[controller_defs::spline::node3_y_idx],
        _controller_data->parameters[controller_defs::spline::node4_y_idx],
        _controller_data->parameters[controller_defs::spline::node5_y_idx],
    };

    float torque_cmd = _spline_interpolate(x, y, percent_gait);
    if (torque_cmd > 15.0f)
    {
        torque_cmd = 15.0f;
    }
    else if (torque_cmd < -15.0f)
    {
        torque_cmd = -15.0f;
    }

    _controller_data->ff_setpoint = torque_cmd;
    _controller_data->filtered_torque_reading = utils::ewma(_joint_data->torque_reading, _controller_data->filtered_torque_reading, 0.5f);

    float cmd = 0.0f;
    if (_controller_data->parameters[controller_defs::spline::use_pid_idx] > 0.0f)
    {
        cmd = torque_cmd + _pid(torque_cmd,
                                _controller_data->filtered_torque_reading,
                                _controller_data->parameters[controller_defs::spline::p_gain_idx],
                                _controller_data->parameters[controller_defs::spline::i_gain_idx],
                                _controller_data->parameters[controller_defs::spline::d_gain_idx]);
    }
    else
    {
        cmd = torque_cmd;
    }

    _controller_data->previous_cmd = cmd;
    _controller_data->desired_torque = torque_cmd;

    return cmd;
}

float Spline::_spline_interpolate(const float* x, const float* y, float percent_gait)
{
    const int n = 5;
    float y2[n];
    float u[n - 1];

    for (int i = 1; i < n; ++i)
    {
        if (x[i] <= x[i - 1])
        {
            return 0.0f;
        }
    }

    if (percent_gait <= x[0])
    {
        return y[0];
    }
    if (percent_gait >= x[n - 1])
    {
        return y[n - 1];
    }

    y2[0] = 0.0f;
    u[0] = 0.0f;

    for (int i = 1; i < n - 1; ++i)
    {
        float sig = (x[i] - x[i - 1]) / (x[i + 1] - x[i - 1]);
        float p = (sig * y2[i - 1]) + 2.0f;
        y2[i] = (sig - 1.0f) / p;

        float dy_next = (y[i + 1] - y[i]) / (x[i + 1] - x[i]);
        float dy_prev = (y[i] - y[i - 1]) / (x[i] - x[i - 1]);
        float dd = dy_next - dy_prev;
        u[i] = (6.0f * dd / (x[i + 1] - x[i - 1]) - sig * u[i - 1]) / p;
    }

    y2[n - 1] = 0.0f;

    for (int k = n - 2; k >= 0; --k)
    {
        y2[k] = y2[k] * y2[k + 1] + u[k];
    }

    int k = 0;
    for (int i = 0; i < n - 1; ++i)
    {
        if (percent_gait >= x[i] && percent_gait <= x[i + 1])
        {
            k = i;
            break;
        }
    }

    float h = x[k + 1] - x[k];
    if (h <= 0.0f)
    {
        return 0.0f;
    }

    float a = (x[k + 1] - percent_gait) / h;
    float b = (percent_gait - x[k]) / h;

    return (a * y[k]) + (b * y[k + 1])
        + (((a * a * a) - a) * y2[k] + ((b * b * b) - b) * y2[k + 1]) * (h * h) / 6.0f;
}


//****************************************************

FranksCollinsHip::FranksCollinsHip(config_defs::joint_id id, ExoData* exo_data)
: _Controller(id, exo_data)
{
    #ifdef CONTROLLER_DEBUG
        logger::println("FranksCollinsHip::Constructor");
    #endif

    last_percent_gait = -1;
    last_start_time = -1;

}

float FranksCollinsHip::calc_motor_cmd()
{
    float start_percent_gait = _controller_data->parameters[controller_defs::franks_collins_hip::start_percent_gait_idx];

    //Calculates the percent gait
    float percent_gait = _get_percent_gait(_controller_data->parameters[controller_defs::franks_collins_hip::sim_gait_idx] > 0.0f);
    float expected_duration = _side_data->expected_step_duration;

    //Determines the time when the user exceeds the defined startpoint of the shifted gait cycle (done to avoid discontinuties realted to heel strike)
    if ((percent_gait >= start_percent_gait) && last_percent_gait < start_percent_gait)
    {
        last_start_time = millis();
    }

    // logger::print("Franks::calc_motor_cmd : _last_start_time = ");
    // logger::print(_last_start_time);
    // logger::print("\n");
    // logger::print("Franks::calc_motor_cmd : percent_gait = ");
    // logger::print(percent_gait);
    // logger::print("\n");
    // logger::print("Franks::calc_motor_cmd : _last_percent_gait = ");
    // logger::print(_last_percent_gait);
    // logger::print("\n");

    //Stores the percent gait for the next loop
    last_percent_gait = percent_gait;

    //Return 0 torque until we have completed a full gait cycle
    if (last_start_time == -1)
    {
        return 0;
    }

    //Calcualtes the shifted percent gait cycle to avoid discontinuity at heel strike
    float shifted_percent_gait = (millis() - last_start_time) / expected_duration * 100;

    // logger::print("Franks::calc_motor_cmd : shifted_percent_gait = ");
    // logger::print(shifted_percent_gait);
    // logger::print("\n");

    float torque_cmd = 0;

    //Pulls in User Defined Controller Parameters
    float mass = _controller_data->parameters[controller_defs::franks_collins_hip::mass_idx];                                               /* User bodymass, currently not used but available if you want to normalize torque mangitude. */
    float extension_torque_peak = _controller_data->parameters[controller_defs::franks_collins_hip::trough_normalized_torque_Nm_kg_idx];    /* Extension torque setpoint. */
    float flexion_torque_peak = _controller_data->parameters[controller_defs::franks_collins_hip::peak_normalized_torque_Nm_kg_idx];        /* Flexion torque setpoint. */

    float extension_torque_magnitude_Nm = -1 * extension_torque_peak;   /* Sign corrected extension torque magnitude. */
    float flexion_torque_magnitude_Nm = flexion_torque_peak;            /* Sign corrected flexion torque magnitude. */

    float mid_time_percent_gait = _controller_data->parameters[controller_defs::franks_collins_hip::mid_time_idx];                          /* % gait cycle of the middle of the zero torque region of the curve. */
    float mid_duration_percent_gait = _controller_data->parameters[controller_defs::franks_collins_hip::mid_duration_idx];                  /* Duration (in % gait cycle) that zero torque is applied */

    float extension_peak_percent_gait = _controller_data->parameters[controller_defs::franks_collins_hip::trough_percent_gait_idx];         /* % gait cycle where the extension torque curve starts. */
    float extension_rise_percent_gait = _controller_data->parameters[controller_defs::franks_collins_hip::trough_onset_percent_gait_idx];   /* % gait cycle where the extension torque curve peaks. */
    float extension_fall_percent_gait = (mid_time_percent_gait - (mid_duration_percent_gait / 2)) - extension_peak_percent_gait;            /* % gait cycle where the extension torque curve ends. */

    float flexion_peak_percent_gait = _controller_data->parameters[controller_defs::franks_collins_hip::peak_percent_gait_idx];             /* % gait cycle where the flexion torque curve starts. */
    float flexion_rise_percent_gait = flexion_peak_percent_gait - (mid_time_percent_gait + (mid_duration_percent_gait / 2));                /* % gait cycle where the flexion torque curve peaks. */
    float flexion_fall_percent_gait = _controller_data->parameters[controller_defs::franks_collins_hip::peak_offset_percent_gait_idx];      /* % gait cycle where the flexion torque curve ends. */

    //logger::print("Franks::calc_motor_cmd : flexion_peak_percent_gait = ");
    //logger::print(flexion_peak_percent_gait);
    //logger::print("\n");

    //logger::print("Franks::calc_motor_cmd : flexion_rise_percent_gait = ");
    //logger::print(flexion_rise_percent_gait);
    //logger::print("\n");

    //logger::print("Franks::calc_motor_cmd : flexion_fall_percent_gait = ");
    //logger::print(flexion_fall_percent_gait);
    //logger::print("\n");

    //Calculates the nodes for the flexion and extension curves for spline generation
    float extension_node1 = extension_peak_percent_gait - extension_rise_percent_gait;
    float extension_node2 = extension_peak_percent_gait;
    float extension_node3 = extension_peak_percent_gait + extension_fall_percent_gait;

    float flexion_node1 = flexion_peak_percent_gait - flexion_rise_percent_gait - (100 - start_percent_gait);
    float flexion_node2 = flexion_peak_percent_gait - (100 - start_percent_gait);
    float flexion_node3 = flexion_peak_percent_gait + flexion_fall_percent_gait - (100 - start_percent_gait);

    //logger::print("Franks::calc_motor_cmd : node1 = ");
    //logger::print(flexion_node1);
    //logger::print("\n");

    //logger::print("Franks::calc_motor_cmd : node2 = ");
    //logger::print(flexion_node2);
    //logger::print("\n");

    //logger::print("Franks::calc_motor_cmd : node3 = ");
    //logger::print(flexion_node3);
    //logger::print("\n");

    //Calculates the feed-forward command by generating the spline curve based on where the user is estimated to be in their gait cycle
    torque_cmd = _spline_generation(extension_node1, extension_node2, extension_node3, extension_torque_magnitude_Nm, shifted_percent_gait) + _spline_generation(flexion_node1, flexion_node2, flexion_node3, flexion_torque_magnitude_Nm, percent_gait);

    //Filter Torque Reading
    _controller_data->filtered_torque_reading = utils::ewma(_joint_data->torque_reading, _controller_data->filtered_torque_reading, 1);

    //Define the Feed-Forward Setpoint
    _controller_data->ff_setpoint = torque_cmd;

    float cmd = 0;

    //Determine if it should be open or closed loop control and calculate accordingly
    if (_controller_data->parameters[controller_defs::franks_collins_hip::use_pid_idx] > 0)
    {
        cmd = torque_cmd + _pid(torque_cmd, _controller_data->filtered_torque_reading, _controller_data->parameters[controller_defs::franks_collins_hip::p_gain_idx], 0, _controller_data->parameters[controller_defs::franks_collins_hip::d_gain_idx]);
    }
    else
    {
        cmd = torque_cmd;
    }

    //Sets the desired torque for plotting
    _controller_data->desired_torque = torque_cmd;

    return cmd;
}

float FranksCollinsHip::_spline_generation(float node1, float node2, float node3, float torque_magnitude, float shifted_percent_gait)
{
    float u;

    float x[3] = {node1, node2, node3};
    float y[3] = {0, torque_magnitude, 0};

    float h[2] = { (x[1] - x[0]), (x[2] - x[1]) };
    float delta[2] = { ((y[1] - y[0]) / h[0]), ((y[2] - y[1]) / h[1]) };

    float dy[3] = { 0, 0, 0};

    if (shifted_percent_gait < x[0] || shifted_percent_gait > x[2])
    {
       u = 0;
    }
    else
    {
        int k = - 1;
        if (shifted_percent_gait >= x[0] && shifted_percent_gait < (x[1]))
        {
            k = 0;
        }
        else if (shifted_percent_gait >= x[1] && shifted_percent_gait < x[2])
        {
            k = 1;
        }

        float a = delta[k];
        float b = (a - dy[k]) / h[k];
        float c = (dy[k + 1] - a) / h[k];
        float d = (c - b) / h[k];

        u = y[k] + (shifted_percent_gait - x[k]) * (dy[k] + (shifted_percent_gait - x[k]) * (b + (shifted_percent_gait - x[k + 1]) * d));
    }

    return u;
}

//****************************************************

ConstantTorque::ConstantTorque(config_defs::joint_id id, ExoData* exo_data)
    : _Controller(id, exo_data)
{
#ifdef CONTROLLER_DEBUG
    logger::println("ConstantTorque::Constructor");
#endif

    //Initializes variables upon startup
    previous_torque_reading = 0;
    previous_command = 0;
    flag = 0;
    difference = 0;

}

float ConstantTorque::calc_motor_cmd()
{

    //Creates the cmd variable and initializes it to 0;
    float cmd_ff = 0;     

    if (_side_data->do_calibration_toe_fsr)          //If the FSRs are being calibrated or if the toe fsr is 0, send a command of zero
    {
        cmd_ff = 0;
    }
    else
    {
        cmd_ff = _controller_data->parameters[controller_defs::constant_torque::amplitude_idx];         //Send a command at the specified amplitude

        if (_controller_data->parameters[controller_defs::constant_torque::direction_idx] == 0)         //If the user wants to send a PF/Flexion torque
        {
            cmd_ff = 1 * cmd_ff;
        }
        else if (_controller_data->parameters[controller_defs::constant_torque::direction_idx] == 1)    //If the user wants to send a DF/Extension torque
        {
            cmd_ff = -1 * cmd_ff;
        }
        else
        {
            cmd_ff = cmd_ff;                                                                            //If the direction flag is something other than 0 or 1, do nothing to the motor command
        }
    }

    //If the command changes
    if (cmd_ff != previous_command)
    {
        flag = 1;                                   //Set the filter flag to 1
        difference = cmd_ff - previous_command;     //Determine the sign of the change in command 
    }

    //If the command is to send a larger torque
    if (difference > 0)
    {
        if (flag == 1 && previous_torque_reading >= cmd_ff)   //Set the flag to 0 when the measured torque reaches the desired setpoint
        {
            flag = 0;
        }
    }

    //If the command is to send a smaller torque 
    if (difference < 0)
    {
        if (flag == 1 && previous_torque_reading <= cmd_ff)   //Set the flag to 0 when the measured torque reaches the desired setpoint 
        {
            flag = 0;
        }
    }

    if (flag == 0)   //If the torque is not changing to meet a new prescribed torque, filter the data
    {
        _controller_data->filtered_torque_reading = utils::ewma(_joint_data->torque_reading, _controller_data->filtered_torque_reading, (_controller_data->parameters[controller_defs::constant_torque::alpha_idx]) / 100);
    }
    else            //If the torque is changing to meet a new prescribed torque, filter the data
    {
        _controller_data->filtered_torque_reading = utils::ewma(_joint_data->torque_reading, _controller_data->filtered_torque_reading, 1);
    }

    //Set the feed-forward setpoint
    _controller_data->ff_setpoint = cmd_ff;

    float cmd = 0;

    //Perform PID control if desired 
    if (_controller_data->parameters[controller_defs::constant_torque::use_pid_idx] > 0)
    {
        cmd = cmd_ff + _pid(cmd_ff, _controller_data->filtered_torque_reading, _controller_data->parameters[controller_defs::constant_torque::p_gain_idx], _controller_data->parameters[controller_defs::constant_torque::i_gain_idx], _controller_data->parameters[controller_defs::constant_torque::d_gain_idx]);
    }
    else
    {
        cmd = cmd_ff;
    }

    previous_command = cmd_ff;

    previous_torque_reading = _controller_data->filtered_torque_reading;

    //Sets the desired torque for plotting
    _controller_data->desired_torque = cmd_ff;

    return cmd;
}

//****************************************************

ElbowMinMax::ElbowMinMax(config_defs::joint_id id, ExoData* exo_data)
    : _Controller(id, exo_data)
{
    #ifdef CONTROLLER_DEBUG
        Serial.println("ElbowMinMax::Constructor");
    #endif

    alpha0 = 0.125;     // Initial FSR Smoothing before searchinng for new max/min - smooths FSR sensor signal noise - only used when doing a manual calibration
    alpha1 = 0.2;       // FSR Sensor Smoothing to Finilize input signal - smooths FSR sensor signal noise
    alpha2 = 0.2;       // Torque Sensor Smoothing before entering PID - smooths torque sensor signal noise
    alpha3 = 0.03;      // Setpoint smoothing to reduce abrupt / jerky applications of torque - lower numbers produce a slower response in torque rise time but increase comfort

    cmd = 0;                    //Initalize Command to 0

    //Smoothing Variables
    Smoothed_Sig_Flex = 0;
    Smoothed_Sig_Ext = 0;
    Smoothed_Flex_Max = 0.2;
    Smoothed_Flex_Min = 0.1;
    Smoothed_Ext_Max = 0.2;
    Smoothed_Ext_Min = 0.1;

    starttime = 0;              //Records the start time for the calibration 

    check = 0;                  //Flag for Calibration

    //Angle Parameters
    Angle_Max = 0;
    Angle_Min = 0;
    Angle = 0;

    //State Parameters
    flexState = 0;
    extState = 0;
    nullState = 0;

    previous_setpoint = 0;  //Stores Previous Setpoint 

    SpringEffect = 0;       //Spring Term Contribution
}

float ElbowMinMax::calc_motor_cmd()
{

    alpha3 = _controller_data->parameters[controller_defs::elbow_min_max::FiltStrength_idx] * 0.01;

    float Sig_Flex = _side_data->toe_fsr;   //(Sensor 1)
    float Sig_Ext = _side_data->heel_fsr;   //(Sensor 2)

    //Filter the incoming FSR signals
    Smoothed_Sig_Flex = ((alpha0 * Sig_Flex) + ((1 - alpha0) * Smoothed_Sig_Flex));
    Smoothed_Sig_Ext = ((alpha0 * Sig_Ext) + ((1 - alpha0) * Smoothed_Sig_Ext));

    // ============================================ Start Manual Calibration Loop: FSR & Angle Sensing ============================================ //

    if ((_controller_data->parameters[controller_defs::elbow_min_max::CaliRequest_idx] == 1) || (_controller_data->parameters[controller_defs::elbow_min_max::CaliRequest_idx] == 2)) 
    {

        //Initialization loop - This loop includes initialization parameters and should only run once when a manual calibration is requested (i.e. the CaliRequest_idx = 1)
        if (_controller_data->parameters[controller_defs::elbow_min_max::CaliRequest_idx] == 1) 
        {

            //Initialize Calibration Start Time
            starttime = millis();

            //Initialize Manual Calibration Parameters    
            Smoothed_Sig_Flex = 0;
            Smoothed_Sig_Ext = 0;
            Smoothed_Flex_Max = 0.2;
            Smoothed_Ext_Max = 0.2;
            Smoothed_Flex_Min = 0.1;
            Smoothed_Ext_Min = 0.1;

            //Flag that calibration has been inialized and plotting FSR signals can begin
            check = 1;
        }

        //Update Calibration Timer
        float timer = millis() - starttime;

        //Check if calibration timer is past 10 seconds, stop is so.
        if (timer > 10000) 
        {
            //Disable this calibration loop, which ensures it get's skipped in the following loop iterations
            _controller_data->parameters[controller_defs::elbow_min_max::CaliRequest_idx] = 0;
        }

        //MIN/MAX Loop - If still in calibration time window (10 seconds), look for new max and min sensor readings
        else if (timer <= 10000) 
        {

            //Set new FSR Sensor Max/Min when found
            Smoothed_Flex_Max = max(Smoothed_Sig_Flex, Smoothed_Flex_Max);
            Smoothed_Flex_Min = min(Smoothed_Sig_Flex, Smoothed_Flex_Min);
            Smoothed_Ext_Max = max(Smoothed_Sig_Ext, Smoothed_Ext_Max);
            Smoothed_Ext_Min = min(Smoothed_Sig_Ext, Smoothed_Ext_Min);


            //Set new Joint Angle Sensor Max/Min when found
            Angle_Max = max(_side_data->ankle.position, Angle_Max);
            Angle_Min = min(_side_data->ankle.position, Angle_Min);

            //Switches the next calibration iteration loop to exclude the initialation loop, which ensures it get's skipped in the following loop iterations
            _controller_data->parameters[controller_defs::elbow_min_max::CaliRequest_idx] = 2;
        }

    }

    // -------------------------------------------- End Manual Calibration Loop: FSR & Angle Sensing --------------------------------------------- //

    // ========================================= Start Automatic Calibration Loop: FSR & Angle Sensing =========================================== //

    //With the default setup (CaliRequest = 3), the program will enter this loop once during startup to determine FSR Min/Max calibration parameters

    else if (_controller_data->parameters[controller_defs::elbow_min_max::CaliRequest_idx] == 3) 
    {


        //Right Glove Predefined Calibration Min & Max Parameters
        if (!_joint_data->is_left) 
        {
            Smoothed_Flex_Max = 4.1;
            Smoothed_Ext_Max = 3.9;
            Smoothed_Flex_Min = 0.1;
            Smoothed_Ext_Min = 0.1;
        }

        //Left Glove Predefined Calibration Min & Max Parameters
        if (_joint_data->is_left) 
        {
            Smoothed_Flex_Max = 4;
            Smoothed_Ext_Max = 2.2;
            Smoothed_Flex_Min = 0.1;
            Smoothed_Ext_Min = 0.1;
        }

        //Disable this calibration loop, which ensures it get's skipped in the following loop iterations
        _controller_data->parameters[controller_defs::elbow_min_max::CaliRequest_idx] = 0;

        //Flag that calibration has been completed
        check = 1;

    }

    // ----------------------------------------- End - Automatic Calibration Loop: FSR & Angle Sensing ------------------------------------------------ //

    // ================================================== FSR and ANGLE Normalization ============================================================== //
    
    //If calibration check has been completed and flagged; Creating signals between 0 and 100% or 0 amd 1.
    if (check == 1) 
    {

        //Normalize FSR data - Smooth the signal with an EMA filter
        _controller_data->FlexSense = (Smoothed_Sig_Flex - Smoothed_Flex_Min) / (Smoothed_Flex_Max - Smoothed_Flex_Min);
        _controller_data->ExtenseSense = (Smoothed_Sig_Ext - Smoothed_Ext_Min) / (Smoothed_Ext_Max - Smoothed_Ext_Min);

        //Normalize Angle Sensor Data
        Angle = (_side_data->ankle.position - Angle_Min) / (Angle_Max - Angle_Min);
    }

    //If calibration has not been completed - just filter the reading without normalization
    else 
    {
        Smoothed_Sig_Flex = ((alpha1 * Sig_Flex) + ((1 - alpha1) * Smoothed_Sig_Flex));
        Smoothed_Sig_Ext = ((alpha1 * Sig_Ext) + ((1 - alpha1) * Smoothed_Sig_Ext));
    }

    // =========================================================== Start: State Detection ======================================================================= //

    //Flexion Condition
    if (_controller_data->FlexSense > (0.05 * _controller_data->parameters[controller_defs::elbow_min_max::DigitFSR_threshold_idx]) && _controller_data->FlexSense > _controller_data->ExtenseSense) 
    {

        _controller_data->ff_setpoint = _controller_data->parameters[controller_defs::elbow_min_max::FLEXamplitude_idx];

        //Update State booleens for torque modifier loop
        flexState = 1;
        extState = 0;
        nullState = 0;

    }

    //Extension Condition
    else if (_controller_data->ExtenseSense > (0.05 * _controller_data->parameters[controller_defs::elbow_min_max::PalmFSR_threshold_idx])) 
    { 

        _controller_data->ff_setpoint = -1 * _controller_data->parameters[controller_defs::elbow_min_max::EXTamplitude_idx];

        //Update State booleens for torque modifier loop
        flexState = 0;
        extState = 1;
        nullState = 0;
    }


    //Zero Torque Condition
    else if (_controller_data->FlexSense < (0.05 * _controller_data->parameters[controller_defs::elbow_min_max::DigitFSR_LOWthreshold_idx]) && _controller_data->ExtenseSense < (0.05 * _controller_data->parameters[controller_defs::elbow_min_max::PalmFSR_LOWthreshold_idx])) 
    {

        _controller_data->ff_setpoint = 0;

        //Update State booleens for torque modifier loop
        flexState = 0;
        extState = 0;
        nullState = 1;
    }

    //Just incase condition
    else 
    {
        _controller_data->ff_setpoint = previous_setpoint;
    }

    //Update previous setpoint for the "Just incase condition"
    previous_setpoint = _controller_data->ff_setpoint;

    // --------------------------------------------------------------- End: State Detection ----------------------------------------------------------------------------- //

    // =========================================================== Start: Torque Profile Modifier ======================================================================= //

    //Setpoint modification - Spring Torque Profile
    if (_controller_data->parameters[controller_defs::elbow_min_max::TrqProfile_idx] == 1) 
    {
        //Flexion Modifier
        if (flexState) 
        {
            //This equation came from a polyfit in excel that maps the desired increase in torque with respect to the normalized angle - specifically for flexion          
            SpringEffect = ((3.1702 * pow(Angle, 3)) - (4.6572 * pow(Angle, 2)) + (0.49 * Angle) + 1.0006) * _controller_data->parameters[controller_defs::elbow_min_max::SpringPkTorque_idx];

            //This sums the selected setpoint (12 Nm) with the torque modifier, to determine the desired setpoint
            _controller_data->ff_setpoint = SpringEffect + _controller_data->ff_setpoint;
        }

        //Extension Modifier
        else if (extState) 
        {
            //This equation came from a polyfit in excel that maps the desired increase in torque with respect to the normalized angle - specifically for extension
            SpringEffect = ((-3.1702 * pow(Angle, 3)) + (4.8521 * pow(Angle, 2)) - (0.6858 * Angle) + (0.0034)) * _controller_data->parameters[controller_defs::elbow_min_max::SpringPkTorque_idx];

            //This sums the selected setpoint (12 Nm) with the torque modifier, to determine the desired setpoint
            _controller_data->ff_setpoint = -1 * SpringEffect + _controller_data->ff_setpoint;
        }

        //Otherwise
        else 
        {
            _controller_data->ff_setpoint = 0;
        }
    }

    // ================================================================== End: Torque Profile Modifier ======================================================================= //

    //Get Filtered torque reading, and setpoint for PID input
    _controller_data->filtered_torque_reading = utils::ewma(_joint_data->torque_reading, _controller_data->filtered_torque_reading, alpha2);
    _controller_data->filtered_setpoint = utils::ewma(_controller_data->ff_setpoint, _controller_data->filtered_setpoint, alpha3);   // Was 0.01 for most trials

    //Saftey Feature - Saturate Torque Setpoint at the max if the modifier gets a wild angle reading (Max Torque Limit)
    if (_controller_data->filtered_setpoint < -1 * _controller_data->parameters[controller_defs::elbow_min_max::TorqueLimit_idx])
    {
        _controller_data->filtered_setpoint = -1 * _controller_data->parameters[controller_defs::elbow_min_max::TorqueLimit_idx];
    }

    if (_controller_data->filtered_setpoint > _controller_data->parameters[controller_defs::elbow_min_max::TorqueLimit_idx])
    {
        _controller_data->filtered_setpoint = _controller_data->parameters[controller_defs::elbow_min_max::TorqueLimit_idx];
    }

    //Get motor command based on PID
    cmd = _controller_data->filtered_setpoint + _pid(_controller_data->filtered_setpoint, _controller_data->filtered_torque_reading, _controller_data->parameters[controller_defs::elbow_min_max::P_gain_idx], _controller_data->parameters[controller_defs::elbow_min_max::I_gain_idx], _controller_data->parameters[controller_defs::elbow_min_max::D_gain_idx]);       //originally, (10, 0, 200)

    //Sets the desired torque for plotting
    _controller_data->desired_torque = _controller_data->filtered_setpoint;

    return cmd;
}

//****************************************************

CalibrManager::CalibrManager(config_defs::joint_id id, ExoData* exo_data)
    : _Controller(id, exo_data)
{
    #ifdef CONTROLLER_DEBUG
        Serial.println("CalibrManager::CalibrManager");
    #endif

}

//The calibration manager "controller" is a self-test tool designed for exo developers to verify the exoskeleton's status. By default, this controller does not use feedback torque control.
float CalibrManager::calc_motor_cmd()
{
	unsigned long CM_clock_curr = millis();
	float cmd;
	
	uint16_t exo_status = _data->get_status();
    bool active_trial = (exo_status == status_defs::messages::trial_on) || 
        (exo_status == status_defs::messages::fsr_calibration) ||
        (exo_status == status_defs::messages::fsr_refinement);
	if ( active_trial && (!_data->user_paused)) {
		
		cmd = 3.5;

		//Currently, for Maxon motors, the motor command isn’t divided by the motor torque constant or gear ratio. Adjust the command accordingly.
		if (_joint_data->motor.motor_type == (uint8_t)config_defs::motor::MaxonMotor)
		{
			cmd = 100;
		}
	}
	else {
		cmd = 0;
	}
	
	// Serial.print("\nExo status: ");
	// Serial.print(String(exo_status));
	// Serial.print("  |  doToeRefinement: ");
	// Serial.print(String(_side_data->do_calibration_refinement_toe_fsr));
	
	#ifdef SIMPLE_DEBUG
		if ((CM_clock_curr - _controller_data->CM_clock) < 1000) {
			_controller_data->filtered_torque_reading = utils::ewma(_joint_data->torque_reading, _controller_data->filtered_torque_reading, 0.5);
			
			_controller_data->ff_setpoint = cmd;
			return cmd;
		}
	#endif
	if (_controller_data->CM_print_num > 0) {
		if (_joint_data->is_left)
		{
			Serial.print("\nLeft angle: ");
			Serial.print(_side_data->ankle.joint_position);
			Serial.print("  |  Left torque: ");
			Serial.print(_joint_data->torque_reading);
			Serial.print("  |  Left cmd: ");
			Serial.print(cmd);
			// Serial.print("  |  Left microSD TRQ: ");
			// Serial.print(_joint_data->torque_reading_microSD);
			// Serial.print("  |  Left TRQ offset: ");
			// Serial.print(_joint_data->torque_offset_reading);
			
			_controller_data->CM_print_num--;
		}
		else
		{
			Serial.print("\nRight angle: ");
			Serial.print(_side_data->ankle.joint_position);
			Serial.print("  |  Right torque: ");
			Serial.print(_joint_data->torque_reading);
			Serial.print("  |  Right cmd: ");
			Serial.print(cmd);
			// Serial.print("  |  Right microSD TRQ: ");
			// Serial.print(_joint_data->torque_reading_microSD);
			// Serial.print("  |  Right TRQ offset: ");
			// Serial.print(_joint_data->torque_offset_reading);
			
			_controller_data->CM_print_num--;
		}
	}
	else {
		_controller_data->CM_clock = millis();
		_controller_data->CM_print_num = 1;
	}
	
	_controller_data->ff_setpoint = cmd;
    return cmd;

    //Sets the desired torque for plotting
    _controller_data->desired_torque = _controller_data->ff_setpoint;

}

//****************************************************

Chirp::Chirp(config_defs::joint_id id, ExoData* exo_data)
    : _Controller(id, exo_data)
{
#ifdef CONTROLLER_DEBUG
    Serial.println("Chirp::Chirp");
#endif

    start_flag = 1;
    start_time = 0;
    current_time = 0;
    previous_amplitude = 0;
}

float Chirp::calc_motor_cmd()
{
    if (_joint_data->is_left)
    {
        float cmd_ff = 0;

        if (start_flag == 1)                    //If this is the first instance of the controller
        {
            start_time = millis();              //Record start time
            start_flag = 0;                     //Disable Flag -> tells us that it is no longer the first instance 
        }

        current_time = millis();                //Records the current time

        float t = (current_time - start_time) / 1000;    //Measure of the time since the start, converts to seconds. 

        float amplitude = _controller_data->parameters[controller_defs::chirp::amplitude_idx];              //Amplitude of the sine wave
        float start_frequency = _controller_data->parameters[controller_defs::chirp::start_frequency_idx];  //Start frequency of the sine wave
        float end_frequency = _controller_data->parameters[controller_defs::chirp::end_frequency_idx];      //End frequency of the sine wave
        float duration = _controller_data->parameters[controller_defs::chirp::duration_idx];                //Duration of the controller
        float yshift = _controller_data->parameters[controller_defs::chirp::yshift_idx];                    //Shifts the center of the sine wave

        float phi = (0 * M_PI / 2);

        float frequency = 0;

        if (t <= duration)                                                                                  //If time is less than the set duration
        {
            frequency = start_frequency + ((end_frequency - start_frequency) * (t / duration));       //Frequency, linearly increases with each iteration of the controller.
            cmd_ff = amplitude * sin(2 * M_PI * frequency * t + phi) + yshift;                                    //Torque command as a sine wave

            if (std::isnan(frequency))                  //If it detects Nan, sets the values to 0, prevents the exo from throwing a fit.
            {
                frequency = start_frequency;
                cmd_ff = 0;
            }
        }

        if (previous_amplitude == 0 && amplitude != 0)  //Flag to restart sine wave without exiting the controller (switch amplitude to zero and then switch it back to what amplitude you want restarts the wave). 
        {
            start_flag = 1;
        }

        previous_amplitude = amplitude;                 //Stores the amplitude to be used in next iteration of the controller. 

        _controller_data->ff_setpoint = cmd_ff;
        _controller_data->filtered_torque_reading = utils::ewma(_joint_data->torque_reading, _controller_data->filtered_torque_reading, 1);

        //PID
        float cmd = cmd_ff +(_controller_data->parameters[controller_defs::chirp::pid_flag_idx]
           ? _pid(cmd_ff, _controller_data->filtered_torque_reading, _controller_data->parameters[controller_defs::chirp::p_gain_idx], _controller_data->parameters[controller_defs::chirp::i_gain_idx], _controller_data->parameters[controller_defs::chirp::d_gain_idx])
           : 0);

        //uint16_t exo_status = _data->get_status();

        //bool active_trial = (exo_status == status_defs::messages::trial_on) || (exo_status == status_defs::messages::fsr_calibration) || (exo_status == status_defs::messages::fsr_refinement);

        //if (active_trial)
        //{

        //    if (_joint_data->is_left)
        //    {

        //        Serial.print(_controller_data->ff_setpoint);
        //        Serial.print(',');
        //        Serial.print(100);
        //        Serial.print("\n");

        //        Serial.print(_controller_data->filtered_torque_reading);
        //        Serial.print(',');
        //        Serial.print(200);
        //        Serial.print("\n");

        //        Serial.print(t * 1000);
        //        Serial.print(',');
        //        Serial.print(300);
        //        Serial.print("\n");

        //        Serial.print(frequency);
        //        Serial.print(',');
        //        Serial.print(400);
        //        Serial.print("\n");

        //    }
        //}

        return cmd;
    }
    else
    {
        return 0;
    }

    //Sets the desired torque for plotting
    _controller_data->desired_torque = _controller_data->ff_setpoint;

}

//****************************************************

Step::Step(config_defs::joint_id id, ExoData* exo_data)
    : _Controller(id, exo_data)
{
#ifdef CONTROLLER_DEBUG
    Serial.println("Step::Step");
#endif

    //Initializes Values
    n = 1;
    start_flag = 1;
    start_time = 0;
    cmd_ff = 0;
    end_time = 0;

    previous_command = 0;
    previous_torque_reading = 0;
    flag = 0;
    difference = 0;
    turn = 0;
    flag_time = 0;
    change_time = 0;

}

float Step::calc_motor_cmd()
{
    
    float Amplitude = _controller_data->parameters[controller_defs::step::amplitude_idx];           //Magnitude of Step Response
    float Duration = _controller_data->parameters[controller_defs::step::duration_idx];             //Duration of Step Response
    int Repetitions = _controller_data->parameters[controller_defs::step::repetitions_idx];         //Number of Step Responses
    float Spacing = _controller_data->parameters[controller_defs::step::spacing_idx];               //Time Between Each Step Response

    float tt = 0;
    uint16_t exo_status = _data->get_status();
    const bool active_trial = (exo_status == status_defs::messages::trial_on) ||
        (exo_status == status_defs::messages::fsr_calibration) ||
        (exo_status == status_defs::messages::fsr_refinement);

    if (_data->user_paused || !active_trial)
    {
        n = 1;
        start_flag = 1;
        start_time = 0;
        previous_time = 0;
        end_time = 0;
        cmd_ff = 0;
        previous_command = 0;
        _controller_data->ff_setpoint = 0;
        _controller_data->desired_torque = 0;
        reset_integral();
        return 0;
    }

    if (n <= Repetitions)                                          //If we are less than the number of desired repetitions
    {
        if (start_flag == 1)                                        //If this is the start of this loop
        {
            start_time = millis();                                  //Record the start time
            start_flag = 0;                                         //Set the flag so that we don't continue to record start time
        }

        float current_time = millis();                              //Measure the current time

        tt = (current_time - start_time) / 1000;                    //Determine the time since the begining of the control iteration, converted to seconds

        if (tt <= Duration)                                         //If the time is less than the desired duration of the step
        {
            cmd_ff = Amplitude;                                     //Apply a torque at the desired magnitude 
        }
        else
        {
            cmd_ff = 0;                                             //Set the torque to 0

            if (previous_time <= Duration && tt > Duration)         //Calculate the time that the amplitude ended
            {
                end_time = millis();
            }

            if (((current_time - end_time)/1000) >= Spacing)        //If the time since ending the step has exceeded our desired spacing
            {
                n = n + 1;                                          //Update the iteration count
                start_flag = 1;                                     //Update the start flag to get a new start time and begin a new cycle
            }
        }

        previous_time = tt;                                         //Record time to be used as previous time in next loop. 

    }
    else
    {
        cmd_ff = 0;
    }

    //Real-Time Torque Filtering if Using Torque Transducer
    //if (cmd_ff != previous_command)
    //{
    //    flag = 1;
    //    difference = cmd_ff - previous_command;
    //    turn = millis();;
    //}

    //if (difference > 0)
    //{
    //    if (flag == 1 && (previous_torque_reading >=  0.9 * cmd_ff))
    //    {
    //        flag = 0;
    //    }
    //}

    //if (difference < 0)
    //{
    //    //if (flag == 1 && (previous_torque_reading <= (1 - 0.9) * cmd_ff))
    //    //{
    //    //    flag = 0;
    //    //}
    //}

    //if (flag == 0)
    //{
    //    _controller_data->filtered_torque_reading = utils::ewma(_joint_data->torque_reading, _controller_data->filtered_torque_reading, (_controller_data->parameters[controller_defs::step::alpha_idx] / 100));
    //}
    //else
    //{
    //    _controller_data->filtered_torque_reading = utils::ewma(_joint_data->torque_reading, _controller_data->filtered_torque_reading, 1);
    //}

    _controller_data->filtered_torque_reading = utils::ewma(_joint_data->torque_reading, _controller_data->filtered_torque_reading, (_controller_data->parameters[controller_defs::step::alpha_idx])/100);

    _controller_data->ff_setpoint = cmd_ff;

    float cmd = cmd_ff;

    if (_controller_data->parameters[controller_defs::step::pid_flag_idx] > 0)
    {
        cmd = cmd_ff + _pid(cmd_ff, _controller_data->filtered_torque_reading, _controller_data->parameters[controller_defs::step::p_gain_idx], _controller_data->parameters[controller_defs::step::i_gain_idx], _controller_data->parameters[controller_defs::step::d_gain_idx]);
    }
    else
    {
        cmd = cmd_ff;
    }

    previous_command = cmd_ff;

    previous_torque_reading = _controller_data->filtered_torque_reading;

    //if (active_trial)
    //{
    //    if (!_joint_data->is_left)
    //    {
    //        Serial.print(_controller_data->ff_setpoint);
    //        Serial.print(',');
    //        Serial.print(100);
    //        Serial.print("\n");

    //        Serial.print(_controller_data->filtered_torque_reading);
    //        Serial.print(',');
    //        Serial.print(200);
    //        Serial.print("\n");

    //        Serial.print(tt*1000);
    //        Serial.print(',');
    //        Serial.print(300);
    //        Serial.print("\n");
    //    }
    //}

    //Sets the desired torque for plotting
    _controller_data->desired_torque = cmd_ff;

    return cmd;
}

/*******************************/

ProportionalHipMoment::ProportionalHipMoment(config_defs::joint_id id, ExoData* exo_data)
    : _Controller(id, exo_data)
{

#ifdef CONTROLLER_DEBUG
    logger::println("ProportionalHipMoment::Constructor");
#endif

    //Initialize variables upon the creation of the controller. 
    state = 2;                      /* Default to Stance to Start. */

    first_state2 = true;            
    first_state3 = true;

    swing_counter = 0;
    state1_counter = 0;
    prev_state1_counter = 130;      /* Estimate of the duration of State 1 for current user so that there is not weird stuff going on at the start. */
    stance_counter = 0;
    swing_duration = 200;           /* Estimate of the duration of Swing for the current user so that there is not weird stuff going on at the start. */

    setpoint = 0.0;
    old_setpoint = 0.0;

    state_count_12 = 0;
    state_count_23 = 0;
    state_count_31 = 0;

    Prev_latestance_duration = 40;  /* Estimate of the duraiton of the prior Late-Stance period so that there is not weird stuff going on at the start. */
    latestance_duration = 40;       /* Estimate of the current Late-Stance period so that there is not weird stuff going on at the start. */
    latestance_counter = 0;
    Alpha_counter = 0.0;
    Alpha = 1.0;                    /* Set to one to avoid scenario where we try to divide by zero during the first cycle through the controller. */
    t = 0.0;

    fs = 0.0;
    fs_min = 0.0;
    prev_fs = 0.0;
    hip_ratio = 0.0;

}

float ProportionalHipMoment::calc_motor_cmd()
{
    //Store Flexion and Extension Setpoints
    float extension_setpoint = _controller_data->parameters[controller_defs::proportional_hip_moment::extension_setpoint_idx];
    float flexion_setpoint = _controller_data->parameters[controller_defs::proportional_hip_moment::flexion_setpoint_idx];

    //State Machine
    switch (state)
    {
        case 1: //Late Swing Phase

            //We are no longer in the transition from stance to swing, so make sure counter is set to 0
            Alpha_counter = 0;

            //Update Number of Iterations in Swing and in State 1
            swing_counter++;
            state1_counter++;

            //Calculate the setpoint as based on linear setpoint
            setpoint = (setpoint + (((extension_setpoint * 0.6) - old_setpoint) / prev_state1_counter));

            //Correct if it exceeds starting point of State 3
            if (setpoint >= extension_setpoint * 0.6)
            {
                setpoint = extension_setpoint * 0.6;
            }

            //Saftey factor so that setpoint does not become crazy high
            if (abs(setpoint) > 20)
            {
                setpoint = 0.0;
            }

            //If the foot is on the ground, we are transitioning from swing to stance (0.03 as the FSR transition value is arbitrary but seems to work, feel free to adjust if needed)
            if (_side_data->toe_fsr > 0.03 || _side_data->heel_stance > 0.03)
            {
                //Update the transition counter 
                state_count_12++;

                //Update the stance counter
                stance_counter++;

                //If we have had 3 straight instances of stance, we know it is not noise and can start to transition to the next state (3 instances seems to be robust but can be adjusted if needed)
                if (state_count_12 >= 3)
                {

                    //If we have been in State 1 for a sufficient enough of time, update the previous duration of State 1
                    if (state1_counter > 3)
                    {
                        prev_state1_counter = state1_counter;
                    }
                    
                    //Update the current State to be Stance 
                    state = 2;

                    //Record the duration of this past Swing phase 
                    swing_duration = swing_counter;

                    //Reset the State Transition Counter for the next cylce
                    state_count_12 = 0;

                    //Make sure the flag for the first instance of State 2 is true 
                    first_state2 = true;

                    //Reset the minimum fs from the previous cycle to 0 for the upcoming cycle
                    fs_min = 0.0;
                }
            }
            else   //This is here to reset these values should we have had non-consecutive detections of Stance 
            {
                state_count_12 = 0;
                stance_counter = 0;
            }

            break;


        case 2: //Stance Phase

            if (first_state2 == true)
            {
                //Reset the Swing Phase and State 1 Counters when we enter Stance Phase 
                swing_counter = 0;
                state1_counter = 0;
                first_state2 = false;
            }

            //Update the number of iterations that we have been in Stance Phase
            stance_counter++; 

            //If we are transitioning from Stance Phase to Swing Phase
            if ((_side_data->toe_fsr <= 0.03) && (_side_data->heel_stance <= 0.3))
            {
                //Increment Swing Counter
                swing_counter++;

                //Increment Stance-to-Swing Counter 
                state_count_23++;   

                //If the transition to Swing Phase is not just noise
                if (state_count_23 >= 3)
                {
                    //Store the Late Stance Duration as the Previous Late Stance Duration for the Next Cycle
                    Prev_latestance_duration = latestance_duration;

                    //Set the Current Late Stance Duration as the Number of Late Stance Iterations We Recorded from this Cycle
                    latestance_duration = latestance_counter;

                    //Reset the Late Stance Counter
                    latestance_counter = 0;

                    //Update the Current State
                    state = 3;

                    //Reset the Transition Counter to 0 for the next cycle 
                    state_count_23 = 0;

                    //Make sure the flag for the first instance of State 3 is true 
                    first_state3 = true;
                }
            }
            else   //This is here to reset these values should we have had non-consecutive detections of Swing 
            {
                state_count_23 = 0;
                swing_counter = 0;
            }

            break;

        case 3: //Early Swing Phase

            if (first_state3 == true)
            {
                //Reset the Stance Counter and State 1 Counter apon entering State 3
                stance_counter = 0;
                state1_counter = 0;
                first_state3 = false;
            }

            //Update the number of iterations in Swing 
            swing_counter++;

            //Update the number of iterations that have occured in the Stance-to-Swing Transition (this scales the end of Stance, see below, until the end of this State)
            Alpha_counter = swing_counter + latestance_duration;

            //Calculate the expected duration of the Stance-to-Swing Transition Period (based on the duration of the last transition period)
            Alpha = ((swing_duration / 2) * 0.3) + Prev_latestance_duration; 

            //Calculate the timing in the current transition phase relative to the previous transition phase 
            t = (Alpha_counter / Alpha);

            //Saftey net to make sure case ends at appropriate point
            if ((((9 * t * t) - (9 * t)) / ((3 * t) - 4)) < 0)
            {
                state1_counter++;
                old_setpoint = setpoint;
                setpoint = 0.0;

                state = 1;
            }

            //Calculate the Setpoint 
            setpoint = ((4 * fs_min * 0.5) - (0.5 * (((9 * t * t) - (9 * t)) / ((3 * t) - 4)))) * flexion_setpoint;

            //Built in a saftey factor in case of large torque setpoint
            if (abs(setpoint) > 20)
            {
                setpoint = 0.0;
            }

            //If we are moving out of Early Swing into Late Swing
            if ((_side_data->toe_fsr <= 0.03) && (_side_data->heel_fsr <= 0.03) && (swing_counter > ((swing_duration / 2) * 0.3)))
            {
                //Count Iterations in transition period 
                state_count_31++;   

                //Start State 1 Counter
                state1_counter++; 

                //If the transition to Late Swing Phase is not just noise
                if (state_count_31 >= 3)
                {
                    //Set the Ending Setpoint of the Transition Phase to the Last Setpoint
                    old_setpoint = setpoint;

                    //Update the Current State to State 1
                    state = 1;

                    //Reset the transition counter to 0
                    state_count_31 = 0;
                }

            }
            else    //This is here to reset these values should we have had non-consecutive detections of the transition
            {
                state_count_31 = 0;
                state1_counter = 0;
            }

            //If we were to suddenly have heel-strike for some reason, transition right to State 2
            if ((_side_data->toe_fsr > 0.03) || (_side_data->heel_fsr > 0.03))
            {
                state = 2;
            }

            break;
    }

    //If we are in stance
    if (state == 2)
    {
        //Determine fs
        fs = _side_data->heel_fsr - (_side_data->toe_fsr * 0.25);

        //Set min fs for this cycle
        if (fs < fs_min)
        {
            fs_min = fs;
        }

        //Handle Late Stance Stuff (if fs is less than 0 the toe is greater than the heel which means we are in late stance)
        if ((fs < 0) || (fs == 0 && prev_fs >= 0)) 
        {
            //If the slope is negative
            if (fs < prev_fs)
            {
                hip_ratio = fs * 4 * 0.5;
            }
            else //We have entered the Late Stance-to-Swing Transition Period
            {
                //Keep count of number of iterations in this late stance phase
                latestance_counter++;

                //Update the number of iterations that have occured in the Stance-to-Swing Transition (this scales the end of Stance until the end of State 5, see above)
                Alpha_counter = latestance_counter;

                //Calculate the expected duration of the Stance-to-Swing Transition Period (based on the duration of the last transition period)
                Alpha = ((swing_duration / 2) * 0.3) + latestance_duration; 

                //Calculate the timing in the current transition phase relative to the previous transition phase 
                t = Alpha_counter / Alpha;

                //Calculate the hip ratio, which will be scaled by the setpoint (see below)
                hip_ratio = ((4 * fs_min * 0.5) - (0.5 * (((9 * t * t) - (9 * t)) / ((3 * t) - 4))));
            }
        }
        else //Handle Early Stance Stuff (If fs is not < 0 then the heel is greater than the toe, which means we are in early stance)
        {
            //If fs is less than 1 and the slope is + then we are just after heel strike and working towards peak extension 
            if ((1 > fs) && (fs != 0) && (prev_fs <= fs))
            {
                hip_ratio = 0.6 + (fs * 0.4);
            }
            else //Handle the post extension transition towards flexion
            {
                hip_ratio = fs;
            }
        }

        //Set the Previous fs to the current fs for the next cycle
        prev_fs = fs;

        //Determine the setpoint
        if (fs <= 0)
        {
            setpoint = hip_ratio * flexion_setpoint;
        }
        else
        {
            setpoint = hip_ratio * extension_setpoint;
        }
    }

    //Store the State in its plotable counterpart (see bottom of ControllerData.h)
    _controller_data->state = state;

    //Set the Feed-Foward Command to the setpoint
    _controller_data->ff_setpoint = setpoint;

    //Store fs in its plotable counterpart (see bottom of ControllerData/h)
    _controller_data->fs = fs;

    //Set the motor command equal to the setpoint, this is for open-loop control, we would need a torque sensor and to call the PID function if we wanted to do closed-loop
    float cmd = setpoint;

    //Sets the desired torque for plotting
    _controller_data->desired_torque = setpoint;

    //Return the Motor Command
    return cmd;
}

//****************************************************

SPV2::SPV2(config_defs::joint_id id, ExoData* exo_data)
: _Controller(id, exo_data)
{
    #ifdef CONTROLLER_DEBUG
        logger::println("SPV2::Constructor");
    #endif
}

void SPV2::_plantar_setpoint_adjuster(SideData* side_data, ControllerData* controller_data, float currentPrescription)
{
	if(_side_data->toe_stance) 
    {	
		//Update peak values
		_controller_data->currentMaxPrescription = max(_controller_data->currentMaxPrescription, currentPrescription);
		_controller_data->wasStance_spv2 = true;
	}
	else 
    {
		if (_controller_data->wasStance_spv2) 
        {
			_controller_data->oldMaxPrescription = _controller_data->currentMaxPrescription;
			_controller_data->currentMaxPrescription = 0;
			
			if (_controller_data->oldMaxPrescription < _controller_data->parameters[controller_defs::spv2::plantar_scaling]) 
            {
			_controller_data->setpoint2use_spv2 = _controller_data->setpoint2use_spv2 + 3;
			}
			else 
            {
				_controller_data->setpoint2use_spv2 --;
			}

			_controller_data->setpoint2use_spv2 = min(_controller_data->setpoint2use_spv2, 65);
			_controller_data->setpoint2use_spv2 = max(_controller_data->setpoint2use_spv2, 0);
			_controller_data->wasStance_spv2 = false;
		}
	}
	if (_controller_data->oldMaxPrescription == 0) 
    {
		_controller_data->setpoint2use_spv2 = _controller_data->parameters[controller_defs::spv2::plantar_scaling];
	}
}

void SPV2::_calc_motor_current(ControllerData* controller_data)
{
	
	if(_controller_data->SPV2_motor_current_ready) {
		Serial.print("\nMotor current ready.");
		_controller_data->SPV2_oldCurrent = _controller_data->SPV2_newCurrent;
		_controller_data->SPV2_newCurrent = _controller_data->SPV2_motor_current / _controller_data->SPV2_motor_current_count ;
		Serial.print("\nnew Current: ");
		Serial.print(_controller_data->SPV2_newCurrent);
		
		_controller_data->SPV2_motor_current = 0;
		_controller_data->SPV2_motor_current_count = 0;
		_controller_data->SPV2_do_count_steps = true;
		_controller_data->SPV2_do_calc_new_stiffness = true;
		_controller_data->SPV2_motor_current_ready = false;
		
		//here to hijack _controller_data->SPV2_newCurrent since it's being used as the cost function output
		//here, we're redefining the cost function.
		_controller_data->SPV2_RMSE = sqrt((_controller_data->SPV2_error_sum) / _controller_data->SPV2_error_count);
		_controller_data->SPV2_CF_output = _controller_data->SPV2_RMSE / (_controller_data->parameters[controller_defs::spv2::plantar_scaling] + 1);
		//the above cost function output is tracking RMSE normalized by the nominal plantarflexion
		
		//_controller_data->SPV2_CF_output = _controller_data->SPV2_CF_output * _controller_data->SPV2_newCurrent;
		_controller_data->SPV2_CF_output = _controller_data->SPV2_newCurrent;
		Serial.print("\n----- CF: ");
		Serial.print(_controller_data->SPV2_CF_output);
		Serial.print(" -----");
	}
	else {
		unsigned long curr_time = millis();
		if ((curr_time - _controller_data->motor_curr_stpWtch) < 100) {
			return;
		}
		_controller_data->motor_curr_stpWtch = curr_time;
		// Serial.print("\nStill accumulating motor current data.");
		// _controller_data->SPV2_motor_current = _controller_data->SPV2_motor_current + abs(analogRead(A1) - 2047);
		// Serial.print("  |  current power: ");
		// Serial.print(_controller_data->SPV2_current_pwr);
		_controller_data->SPV2_motor_current = _controller_data->SPV2_motor_current + _controller_data->SPV2_filtered_pwr;
		_controller_data->SPV2_motor_current_count++;//number of frames (not number of steps)
		
		//calculation for the updated cost function. The goal for the updated cost function is to evaluate both the motor current and the tracking error.
		//First, let's calculate the tracking errors
		_controller_data->SPV2_error_sum = _controller_data->SPV2_error_sum + pow(_controller_data->ff_setpoint - _controller_data->filtered_torque_reading, 2);
		_controller_data->SPV2_error_count++;
	}
}

void SPV2::_stiffness_adjustment(uint8_t minAngle, uint8_t maxAngle, ControllerData* controller_data)
{
	//Simulated Annealing debug
	//_controller_data->SPV2_do_calc_new_stiffness = true;
	
	//Update stiffness adjustment target angle
	//Use change of motor current to update the stiffness target angle
	if (_controller_data->SPV2_do_calc_new_stiffness) {
		uint16_t newCurrent = _controller_data->SPV2_newCurrent;
		uint16_t oldCurrent = _controller_data->SPV2_oldCurrent;
		uint8_t adjIncrement = _controller_data->parameters[controller_defs::spv2::spring_stiffness_adj_factor];
		//here to assign the new stiffness adjustment servo angle
		// _controller_data->SPV2_currentAngle = _controller_data->SPV2_currentAngle + (((newCurrent - oldCurrent) > 0) - ((newCurrent - oldCurrent) < 0)) * (-adjIncrement);//"((x>0)-(x<0))" extracts the sign of "x", source: https://forum.arduino.cc/t/sgn-sign-signum-function-suggestions/602445/5 
		
		// Serial.print("\n _controller_data->do_adv_optimizer: ");
		// Serial.print(_controller_data->do_adv_optimizer);
		
		switch (_controller_data->do_adv_optimizer) {
			case 2:
			// _SA_point_gen(30, minAngle, maxAngle, 1000);
			_lab_OP_point_gen(30, minAngle, maxAngle);
			_controller_data->SPV2_currentAngle = _controller_data->candidate;
			break;
			case -1://these numerical switch case values don't make much sense, will update afterward
			_golden_search_advance();
			_controller_data->SPV2_currentAngle = _controller_data->x1;
			_controller_data->do_adv_optimizer = 1;
			Serial.print("\n Running golden loop 1");
			//Serial.print("  |  NXT x1 set!");
			break;
			case 1:
			_controller_data->SPV2_currentAngle = _controller_data->x2;
			_controller_data->do_adv_optimizer = -1;
			//Serial.print("  |  NXT x2 set!");
			Serial.print("\n Running golden loop 1");
			break;			
			default:
			// _SA_point_gen(30, minAngle, maxAngle, 1000);
			_lab_OP_point_gen(30, minAngle, maxAngle);
			_controller_data->SPV2_currentAngle = _controller_data->candidate;
			_controller_data->do_adv_optimizer = 2;
			//_controller_data->SPV2_currentAngle = _SA_point_gen(10, true, 60, 120);
			// if (_controller_data->SPV2_gs_is_ini_itr) {
				// _controller_data->SPV2_currentAngle = _controller_data->x1;
				// _controller_data->SPV2_gs_is_ini_itr = false;
				// Serial.print("  |  OG x1 set!");
			// }
			// else {
				// _controller_data->SPV2_currentAngle = _controller_data->x2;
				// _controller_data->do_adv_optimizer = -1;
				// _controller_data->SPV2_gs_is_ini_itr = true;
				// Serial.print("  |  OG x2 set!");
			// }
			break;
		}
		_controller_data->SPV2_do_calc_new_stiffness = false;
		// _controller_data->SPV2_currentAngle = min(maxAngle, _controller_data->SPV2_currentAngle);
		// _controller_data->SPV2_currentAngle = max(minAngle, _controller_data->SPV2_currentAngle);
		_controller_data->SPV2_currentAngle = constrain(_controller_data->SPV2_currentAngle, minAngle, maxAngle);
	
	}
}

void SPV2::_step_counter(uint16_t num_steps_threshold, SideData* side_data, ControllerData* controller_data)
{
	if (_controller_data->SPV2_do_count_steps) {
		if ((!_side_data->prev_toe_stance) && (_side_data->toe_stance)) {
			_controller_data->SPV2_step_count++;
		}
		if (_controller_data->SPV2_step_count == num_steps_threshold) {
			_controller_data->SPV2_step_count = 0;
			_controller_data->SPV2_do_count_steps = false;
			_controller_data->SPV2_motor_current_ready = true;
		}
		
	}
}

void SPV2::_golden_search_advance()
{
	if (_controller_data->do_adv_optimizer == -1) {
		_controller_data->x1_current = _controller_data->SPV2_oldCurrent;
		_controller_data->x2_current = _controller_data->SPV2_newCurrent;
		if (_controller_data->x1_current > _controller_data->x2_current) {
			_controller_data->x_l = _controller_data->x2;
			//x_u = x_u; //unchanged
		}
		else {
			_controller_data->x_u = _controller_data->x1;
			//x_l = x_l; //unchanged
		}
	_controller_data->x1 = _controller_data->x_l + ((sqrt(5) - 1)/2) * (_controller_data->x_u - _controller_data->x_l);//servo motor angle 1
	_controller_data->x2 = _controller_data->x_u - ((sqrt(5) - 1)/2) * (_controller_data->x_u - _controller_data->x_l);//servo motor angle 2
	// Serial.print("\n_controller_data->x1: ");
	// Serial.print(_controller_data->x1);
	// Serial.print("  |  _controller_data->x2: ");
	// Serial.print(_controller_data->x2);
	}
}

void SPV2::optimizer_reset()
{
	// Serial.print("\n  |  optimizer just RESET.");
	_controller_data->do_adv_optimizer = 0;
	_controller_data->SPV2_gs_is_ini_itr = true;
	_controller_data->i_SA = 0;
	
	_controller_data->SPV2_step_count = 0;
	_controller_data->SPV2_do_count_steps = true;//always ready to count number of steps once the servo switch is ON
	_controller_data->SPV2_motor_current_ready = false;
	
	_controller_data->SPV2_motor_current = 0;
	_controller_data->SPV2_motor_current_count = 0;
	_controller_data->SPV2_oldCurrent = 0;
	_controller_data->SPV2_newCurrent = 0;
	
	_controller_data->SPV2_error_sum = 0;
	_controller_data->SPV2_error_count = 0;
	
}

void SPV2::_SA_point_gen(float step_size, long bound_l, long bound_u, float temp)
{
	if (_controller_data->SPV2_newCurrent==0) {
		return;
	}
	_controller_data->i_SA++;
	//Simulated Annealing debug
	Serial.print("\n----i_SA: ");
	Serial.print(_controller_data->i_SA);
	
	if (_controller_data->i_SA == 1) {
		randomSeed((micros())%(analogRead(20)*analogRead(0)));
		float random_num_2 = random(1001);
		float random_component_2 = ((random_num_2)/1000);
		_controller_data->curr = bound_l + random_component_2 * (bound_u - bound_l);
		_controller_data->candidate = _controller_data->curr;
		_controller_data->best = _controller_data->curr;
		//return best;//initial point
	}

	else {
		if (_controller_data->i_SA == 2) {
			//randomSeed((micros())%(analogRead(20)*analogRead(0)));
			//_controller_data->curr_eval = _controller_data->SPV2_newCurrent;
			_controller_data->curr_eval = _controller_data->SPV2_CF_output;
			_controller_data->best_eval = _controller_data->curr_eval;
			Serial.print("\n_controller_data->i_SA == 2");
			
			//Simulated Annealing debug
			// _controller_data->curr_eval =  pow(_controller_data->candidate, 2);
			// _controller_data->best_eval = _controller_data->curr_eval;
		}
		//_controller_data->candidate_eval = _controller_data->SPV2_newCurrent;
		_controller_data->candidate_eval = _controller_data->SPV2_CF_output;
		
		//Simulated Annealing debug
		// _controller_data->candidate_eval =  pow(_controller_data->candidate, 2);
		
		
		if (_controller_data->candidate_eval < _controller_data->best_eval) {
			_controller_data->best = _controller_data->candidate;
			_controller_data->best_eval = _controller_data->candidate_eval;			
		}
		float diff = _controller_data->candidate_eval - _controller_data->curr_eval;
		float t = temp / _controller_data->i_SA;
		float metropolis = exp(-diff / t);
		//if ((diff < 0) || (random(0, 1)) < metropolis) { // Issue noticed: random(0,1) wouldn't work as expected because of its "long" variable type
		float random_num_1 = random(1001);
		float random_component_1 = ((random_num_1)/1000);
		if ((diff < 0) || (random_component_1 < metropolis)) {
			_controller_data->curr = _controller_data->candidate;
			_controller_data->curr_eval = _controller_data->candidate_eval;
		}
		float random_num = random(1001);
		float random_component = ((random_num - 500)/1000)*(step_size);
		//float random_component = ((static_cast<float>(random_num) - 500)/1000)*(step_size);
		_controller_data->candidate = _controller_data->curr + random_component;
		// Serial.print("  |  candidate: ");
		// Serial.print(_controller_data->candidate);
		// Serial.print("  |  random_component: ");
		// Serial.print(random_component);
		
		_controller_data->candidate = constrain(_controller_data->candidate, bound_l, bound_u);
		
		//Simulated Annealing debug
		/* if (_controller_data->i_SA < 100000) {
			Serial.print("\n----i_SA: ");
			Serial.print(_controller_data->i_SA);
			Serial.print("  |  candidate: ");
			Serial.print(_controller_data->candidate);
			Serial.print("  |  candidate_eval: ");
			Serial.print(_controller_data->candidate_eval);
			
			Serial.print("  |  best: ");
			Serial.print(_controller_data->best);
			Serial.print("  |  best_eval: ");
			Serial.print(_controller_data->best_eval);
			
			
		} */
	}
	
	
	//example from https://machinelearningmastery.com/simulated-annealing-from-scratch-in-python/
	
}

void SPV2::_lab_OP_point_gen(float step_size, long bound_l, long bound_u)
{
	if (_controller_data->SPV2_newCurrent==0) {
		return;
	}
	_controller_data->i_SA++;
	Serial.print("\n----i_SA (Lab OP): ");
	Serial.print(_controller_data->i_SA);
	
	if (_controller_data->i_SA == 1) {
		_controller_data->candidate = _controller_data->parameters[controller_defs::spv2::neutral_angle];
		_controller_data->old_candidate = _controller_data->candidate;

	}

	else {
		signed long delta_pwr = _controller_data->SPV2_newCurrent - _controller_data->SPV2_oldCurrent;
		int8_t candidate_dir = ((_controller_data->candidate - _controller_data->old_candidate>0)?1:-1);
		_controller_data->old_candidate = _controller_data->candidate;
		int8_t pwr_dir = ((delta_pwr>0)?1:-1);
		int8_t curr_dir = -1 * candidate_dir * pwr_dir;
		_controller_data->candidate = _controller_data->candidate + step_size * 0.001 * abs(delta_pwr) * (curr_dir);
		Serial.print("\n----delta_pwr: ");
		Serial.print(delta_pwr);
		Serial.print("  ----raw candidate: ");
		Serial.print(_controller_data->candidate);
		Serial.print("  ----step_size: ");
		Serial.print(step_size);

	}
	_controller_data->candidate = constrain(_controller_data->candidate, bound_l, bound_u);
}

void SPV2::_update_reference_angles(SideData* side_data, ControllerData* controller_data, float percent_grf, float percent_grf_heel)
{
    //When the percent_grf passes the threshold, update the reference angle
    // const float threshold = controller_data->parameters[controller_defs::trec::timing_threshold]/100;
	const float threshold = 35/100;
    const bool should_update = (percent_grf >  _controller_data->toeFsrThreshold) && !_controller_data->reference_angle_updated;
    const bool should_capture_level_entrance = side_data->do_calibration_refinement_toe_fsr && !side_data->do_calibration_toe_fsr;
	// Serial.print("\nshould_capture_level_entrance: ");
	// Serial.print(should_capture_level_entrance);
    const bool should_reset_level_entrance_angle =  _controller_data->prev_calibrate_level_entrance < should_capture_level_entrance;

    if (should_reset_level_entrance_angle)
    {
         _controller_data->level_entrance_angle = 0.5;
    }

    if (should_update)
    {
        if (should_capture_level_entrance)
        {
             _controller_data->level_entrance_angle = utils::ewma(side_data->ankle.joint_position,  _controller_data->level_entrance_angle,  _controller_data->cal_level_entrance_angle_alpha);
        }

         _controller_data->reference_angle_updated = true;
         _controller_data->reference_angle = side_data->ankle.joint_position;
        
        // _controller_data->reference_angle_offset = side_data->ankle.joint_global_angle;
    }

    //When the percent_grf drops below the threshold, reset the reference angle updated flag and expire the reference angle
    const bool should_reset = (percent_grf <  _controller_data->toeFsrThreshold) &&  _controller_data->reference_angle_updated;
    
    if (should_reset)
    {
         _controller_data->reference_angle_updated = false;
         _controller_data->reference_angle = 0;
         _controller_data->reference_angle_offset = 0;
    }

     _controller_data->prev_calibrate_level_entrance = should_capture_level_entrance;
}

void SPV2::_capture_neutral_angle(SideData* _side_data, ControllerData* controller_data)
{
    //On the start of torque calibration reset the neutral angle
    if ( _controller_data->prev_calibrate_trq_sensor < _side_data->ankle.calibrate_torque_sensor)
    {
         _controller_data->neutral_angle = _side_data->ankle.joint_position;
    }

    if (_side_data->ankle.calibrate_torque_sensor) 
    {
        //Update the neutral angle with an ema filter
         _controller_data->neutral_angle = utils::ewma(_side_data->ankle.joint_position,  _controller_data->neutral_angle,  _controller_data->cal_neutral_angle_alpha);
    }

     _controller_data->prev_calibrate_trq_sensor = _side_data->ankle.calibrate_torque_sensor;
}

void SPV2::_grf_threshold_dynamic_tuner(SideData* _side_data, ControllerData* controller_data, float threshold, float percent_grf_heel)
{
	 _controller_data->toeFsrThreshold = threshold;
	return;
	//If it's swing phase, set wait4HiHeelFSR to True, and increase the toeFSR threshold; when wait4HiHeelFSR is true and heelFSR > a pre-defined threshold, reduce the toeFSR threshold; when it's stance phase, set wait4HiHeelFSR to False
	if (!_side_data->toe_stance)
    {
		 _controller_data->wait4HiHeelFSR = true;
	}
	else
    {
		 _controller_data->wait4HiHeelFSR = false;
		 _controller_data->toeFsrThreshold = threshold*0.01;
	}
	if ( _controller_data->wait4HiHeelFSR) 
    {
		if (percent_grf_heel > threshold) 
        {
			 _controller_data->toeFsrThreshold = threshold*0.1;
		}
		else 
        {
			 _controller_data->toeFsrThreshold = threshold;
		}
	}
}

float SPV2::calc_motor_cmd()
{
	//Serial.print("\nfloat SPV2::calc_motor_cmd()");

	if (_joint_data->is_left) {
		return 0;
	}
	else {
		
		float servo_fsr_threshold = 0.01 * _controller_data->parameters[controller_defs::spv2::fsr_servo_threshold];
		uint8_t servo_home = _controller_data->parameters[controller_defs::spv2::servo_origin];
		uint8_t servo_target = _controller_data->parameters[controller_defs::spv2::servo_terminal];
		bool optimizer_switch = _controller_data->parameters[controller_defs::spv2::do_update_stiffness];
		bool SD_content_imported = (((servo_home == 0)&&(servo_target == 0)&&(servo_fsr_threshold == 0))?false: true);
		uint8_t neutral_stiffness = _controller_data->parameters[controller_defs::spv2::neutral_angle];
		if (_controller_data->parameters[controller_defs::spv2::soft_or_stiff] == 1) {
			neutral_stiffness = _controller_data->parameters[controller_defs::spv2::servo_angle_soft];
		}
		else if (_controller_data->parameters[controller_defs::spv2::soft_or_stiff] == 2) {
			neutral_stiffness = _controller_data->parameters[controller_defs::spv2::servo_angle_stiff];
		}
		else if ((_controller_data->parameters[controller_defs::spv2::soft_or_stiff] >= 10) && (_controller_data->parameters[controller_defs::spv2::soft_or_stiff] <= 20)) {
			uint8_t stiffness_cache = map(_controller_data->parameters[controller_defs::spv2::soft_or_stiff], 10, 20, _controller_data->parameters[controller_defs::spv2::servo_angle_soft], _controller_data->parameters[controller_defs::spv2::servo_angle_stiff]);

			neutral_stiffness = max(min(stiffness_cache,max(_controller_data->parameters[controller_defs::spv2::servo_angle_soft], _controller_data->parameters[controller_defs::spv2::servo_angle_stiff])),min(_controller_data->parameters[controller_defs::spv2::servo_angle_soft], _controller_data->parameters[controller_defs::spv2::servo_angle_stiff]));

		}
		
		

		if (!SD_content_imported) {
			return 0;
		}
		
		
		uint16_t exo_status = _data->get_status();
		bool active_trial = (exo_status == status_defs::messages::trial_on) || (exo_status == status_defs::messages::fsr_calibration) || (exo_status == status_defs::messages::fsr_refinement);
		
		//Block uncomment the following section if the device has an INA260 chip
		/* if (!_controller_data->ps_connected) {
			if (!ina260.begin()) {
				Serial.println("Couldn't find INA260 chip");
				while (1);
			}
			else {
				_controller_data->ps_connected = true;
			}
		}
		
		// Serial.print("  |  Power: ");
		_controller_data->SPV2_current_pwr = ina260.readPower();
		_controller_data->SPV2_filtered_pwr = utils::ewma(_controller_data->SPV2_current_pwr, _controller_data->SPV2_filtered_pwr, 0.05);//0.05 returns a profile that matches the average Maxon motor current
		//Serial.print(ina260.readPower());
		// Serial.print(_controller_data->SPV2_current_pwr);
		// Serial.print(" mW");
		// Serial.print("  |  Bus Voltage: ");
		// Serial.print(ina260.readBusVoltage());
		// Serial.println(" mV");
		
		long millis_time = millis();
		if (millis_time-_controller_data->SPV2_current_voltage_timer > 10000) {
			_controller_data->SPV2_current_voltage = ina260.readBusVoltage();// bus voltage returned in millis volts
			_controller_data->SPV2_current_voltage_timer = millis_time;
		}
		//Serial.print("\n*********Teensy received battery voltage: ");
		//Serial.print(ina219.getBusVoltage_V());
		//Calculate system power usage during 30 seconds */
		
		
	//Calculate Generic Contribution
	float plantar_setpoint = _controller_data->parameters[controller_defs::spv2::plantar_scaling];
	float dorsi_setpoint = _controller_data->parameters[controller_defs::spv2::dorsi_scaling];
	float threshold = constrain(_controller_data->parameters[controller_defs::spv2::timing_threshold]/100, 0, 99);
	float percent_grf = constrain(_side_data->toe_fsr, 0, 2.5);
	float percent_grf_heel = constrain(_side_data->heel_fsr, 0, 2.5);
	_controller_data->percent_grf2plot= percent_grf;
	_controller_data->percent_grf_heel2plot= percent_grf_heel;

	
	if (_controller_data->parameters[controller_defs::spv2::turn_on_peak_limiter]) 
    {
		plantar_setpoint = _controller_data->setpoint2use_spv2;
	}
	else 
    {
		plantar_setpoint = _controller_data->parameters[controller_defs::spv2::plantar_scaling];
		_controller_data->setpoint2use_spv2 = plantar_setpoint;
	}

	
	float cmd_pjmc = _pjmc_generic(percent_grf, threshold, dorsi_setpoint, -plantar_setpoint);
	cmd_pjmc = min(dorsi_setpoint, cmd_pjmc);//cap the dorsiflexion setpoint
	
	float cmd_ff = cmd_pjmc;
	cmd_ff = constrain(cmd_ff, -45, 3);

	_controller_data->cmd_ff2plot = _controller_data->cmd_ff_generic;

    //Low pass filter torque_reading
    const float torque = _joint_data->torque_reading;
    const float alpha = 0.5;
    _controller_data->filtered_torque_reading = utils::ewma(torque, _controller_data->filtered_torque_reading, alpha);
	
	if (_controller_data->parameters[controller_defs::spv2::turn_on_peak_limiter]) 
    {
		if (_data->user_paused || !active_trial) {
			_controller_data->setpoint2use_spv2 = 0;
			/* plantar_setpoint = _controller_data->parameters[controller_defs::spv2::plantar_scaling];
			_controller_data->setpoint2use_spv2 = plantar_setpoint; */
		}
		else {
			
			_plantar_setpoint_adjuster(_side_data, _controller_data, -_controller_data->filtered_torque_reading);
		// _plantar_setpoint_adjuster(_side_data, _controller_data, -cmd_pjmc);
		}
		
	}
	// Serial.print("\n-----------_controller_data->setpoint2use_spv2: ");
	// Serial.print(_controller_data->setpoint2use_spv2);
	
	float cmd;


		if (cmd_ff < -0.5)
        {
			cmd = cmd_ff + _pid(cmd_ff, _controller_data->filtered_torque_reading, 20 * _controller_data->parameters[controller_defs::spv2::kp], 80 * _controller_data->parameters[controller_defs::spv2::ki], 20 * _controller_data->parameters[controller_defs::spv2::kd]);
			// cmd = cmd_ff + _pid(cmd_ff, _controller_data->filtered_torque_reading, 20 * _controller_data->parameters[controller_defs::spv2::kp], 0 * _controller_data->parameters[controller_defs::spv2::ki], 20 * _controller_data->parameters[controller_defs::spv2::kd]);
		}
		else
        {
			cmd = cmd_ff + _pid(cmd_ff, _controller_data->filtered_torque_reading, 10 * _controller_data->parameters[controller_defs::spv2::kp], 80 * _controller_data->parameters[controller_defs::spv2::ki], 20 * _controller_data->parameters[controller_defs::spv2::kd]); // less jittery during zero-torque mode
			// cmd = cmd_ff + _pid(cmd_ff, _controller_data->filtered_torque_reading, 10 * _controller_data->parameters[controller_defs::spv2::kp], 0 * _controller_data->parameters[controller_defs::spv2::ki], 20 * _controller_data->parameters[controller_defs::spv2::kd]);
		}
	
    //Establish Setpoints
	_controller_data->ff_setpoint = cmd_ff; 
	_controller_data->setpoint = cmd;
    _controller_data->filtered_setpoint = cmd;

    #ifdef CONTROLLER_DEBUG
        logger::println("SPV2::calc_motor_cmd : stop");
    #endif
		
	bool servo_switch = _controller_data->parameters[controller_defs::spv2::do_use_servo];
	// if (_controller_data->parameters[controller_defs::spv2::plantar_scaling]) {
		// servo_switch = true;
	// }
	// else {
		// servo_switch = false;
	// }
	
	if (_data->user_paused || !active_trial)
	{
		if (SD_content_imported)
		{
			utils::actuate_servo(27, servo_home);
		}
	}
	else
    {
		// Serial.print("  |  |  |  Battery voltage (mV): ");
		// Serial.print(_controller_data->SPV2_current_voltage);
		
		if (!servo_switch)
        {
			utils::actuate_servo(27, servo_home);
		}
		
		if (exo_status == status_defs::messages::fsr_refinement)
		{
			_controller_data->SPV2_fsr_calibrated_once = true;
		}
		
		if (_controller_data->SPV2_fsr_calibrated_once)
        {
			
			
                //Servo movement
                //When does the arm go DOWN?//
				//Reset only after toe FSR drops below a threshold
				if ((percent_grf_heel + percent_grf > servo_fsr_threshold) && (!_controller_data->servo_did_go_down))
                {
					if (servo_switch)
                    {
					    _controller_data->servo_get_ready = true;
					    _controller_data->servo_departure_time = millis();
					}
				}

				if (percent_grf_heel + percent_grf < servo_fsr_threshold)
                {
					_controller_data->servo_did_go_down = false;
				}
				
				if (_controller_data->servo_get_ready)
                {
					if ((millis() - _controller_data->servo_departure_time) < 300)
                    {
						//Servo goes to the target position (DOWN)
						utils::actuate_servo(27, servo_target);
						_controller_data->servo_did_go_down = true;
					}
					else
                    {	
						_controller_data->servo_get_ready = false;
					}
				}
				else
                {
					//Servo goes back to the home position (UP)
					utils::actuate_servo(27, servo_home);
				}
				

				if (optimizer_switch) {
					_step_counter(_controller_data->parameters[controller_defs::spv2::motor_current_calc_win], _side_data, _controller_data);
					_calc_motor_current(_controller_data);
					_stiffness_adjustment(_controller_data->parameters[controller_defs::spv2::min_angle], _controller_data->parameters[controller_defs::spv2::max_angle], _controller_data);
					// Serial.print(" -- Another itr.");
				}
				else {
					optimizer_reset();//make it a fresh start every time the optimizer switch is ON again
				}
				if (!_side_data->toe_stance) {
					
						//Pull the initial stiffness angle from the SD card
						if ((_controller_data->SPV2_oldCurrent == 0) && (_controller_data->SPV2_newCurrent == 0)) {
						// if (_controller_data->SPV2_oldCurrent == 0)  {
							// _controller_data->SPV2_currentAngle = _controller_data->parameters[controller_defs::spv2::neutral_angle];
							_controller_data->SPV2_currentAngle = neutral_stiffness;
							_controller_data->SPV2_currentAngle = constrain(_controller_data->SPV2_currentAngle, _controller_data->parameters[controller_defs::spv2::min_angle], _controller_data->parameters[controller_defs::spv2::max_angle]);
							
							_controller_data->x1 = _controller_data->parameters[controller_defs::spv2::min_angle];
							_controller_data->x2 = _controller_data->parameters[controller_defs::spv2::max_angle];
							// Serial.print("\n\n----- OG x1 x2 pulled from SD -----\n\n");
						}
					
					
				Serial.print("\n******Stiffness servo angle: ");
				Serial.print(_controller_data->SPV2_currentAngle);
					utils::actuate_servo(26, _controller_data->SPV2_currentAngle);
	
				}
				
				//Serial.print("\nStep count: ");
				//Serial.print(_controller_data->SPV2_step_count);
			_controller_data->SPV2_motor_off = 20;
			if ((servo_switch) && (_controller_data->servo_did_go_down) && ((_controller_data->filtered_torque_reading - cmd_ff) < 0) && (percent_grf > 0.02))
			{
				cmd = _pid(0, 0, 0, 0, 0);  //Reset the PID error sum by sending a 0 I gain
				cmd = -20;                    //Send 0 Nm torque command to "turn off" the motor to extend the battery life
				_controller_data->SPV2_motor_off = -20;
			}
			
		}
		else {
			//when the FSR is being calibrated, move the servo out of the way
			utils::actuate_servo(27, servo_home);
		}
	}

		
		//Leaf spring stiffness measurement ends
		
		if (!(cmd == cmd)) {
			//Serial.print("\n!(cmd == cmd)............");
			return 0;
		}
		else {
			return cmd;
			//return 0;
		}

	}

    //Sets the desired torque for plotting
    _controller_data->desired_torque = _controller_data->ff_setpoint;

}

//****************************************************

PJMC_PLUS::PJMC_PLUS(config_defs::joint_id id, ExoData* exo_data)
: _Controller(id, exo_data)
{
    #ifdef CONTROLLER_DEBUG
        logger::println("PJMC_PLUS::Constructor");
    #endif
}

float PJMC_PLUS::calc_motor_cmd()
{
	// Calculate Generic Contribution
	float plantar_setpoint = _controller_data->parameters[controller_defs::pjmc_plus::plantar_scaling];
	float dorsi_setpoint = _controller_data->parameters[controller_defs::pjmc_plus::dorsi_scaling];
	float threshold = constrain(_controller_data->parameters[controller_defs::pjmc_plus::timing_threshold]/100, 0, 99);
	float percent_grf = constrain(_side_data->toe_fsr, 0, 1.5);
	float percent_grf_heel = constrain(_side_data->heel_fsr, 0, 1.5);
	float cmd_ff = _pjmc_generic(percent_grf, threshold, dorsi_setpoint, -plantar_setpoint);
	cmd_ff = min(dorsi_setpoint, cmd_ff);//cap the dorsiflexion setpoint
	
	// if (!_joint_data->is_left){
		// Serial.print("\nRunning pjmcPlus...");
		// Serial.print(cmd_ff);
	// }
    
    //Low-pass filter on torque_reading
    const float torque = _joint_data->torque_reading;
    const float alpha = 0.5;
    _controller_data->filtered_torque_reading = utils::ewma(torque, _controller_data->filtered_torque_reading, alpha);
	
	float cmd;
	
    //PID on Motor Command
    cmd = cmd_ff + _pid(cmd_ff, _controller_data->filtered_torque_reading, _controller_data->parameters[controller_defs::pjmc_plus::kp], _controller_data->parameters[controller_defs::pjmc_plus::ki], _controller_data->parameters[controller_defs::pjmc_plus::kd]);

    #ifdef CONTROLLER_DEBUG
    logger::println("pjmcPlus::calc_motor_cmd : stop");
    #endif
	
	//Establish Setpoints
	_controller_data->ff_setpoint = cmd_ff; 
	_controller_data->setpoint = cmd;
    _controller_data->filtered_setpoint = cmd;
	
    //Sets the desired torque for plotting
    _controller_data->desired_torque = _controller_data->ff_setpoint;
    
	return cmd;
}

//**************************************************

FSRless::FSRless(config_defs::joint_id id, ExoData* _exo_data)
: _Controller(id, _exo_data)
{
    #ifdef CONTROLLER_DEBUG
        logger::println("FSRless::Constructor");
    #endif

    first_loop = true;
    second_loop = false;

    encoder_offset = 0.0;
    encoder_angle = 0.0;
    prev_encoder_angle = 0.0;
    norm_angle = 0.0;
    prev_norm_angle = 0.0;
    max_angle = 0.0;
    min_angle = 0.0;

    encoder_vel = 0.0;
    prev_encoder_vel = 0.0;
    norm_vel = 0.0;
    prev_norm_vel = 0.0;
    max_vel = 0.0;
    min_vel = 0.0;

    encoder_acc = 0.0;
    prev_encoder_acc = 0.0;
    norm_acc = 0.0;
    max_acc = 0.0;
    min_acc = 0.0;

    angle_setpoint = 0.9;
    is_flexion = false;

    last_switch = millis();

    Serial.println("FSRless Contructor");
}
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
