naubiomech/OpenExo/ExoCode/src/Controller.h

/**
 * @file Controller.h
 *
 * @brief Declares for the different controllers the exo can use. 
 * Controllers should inherit from _Controller class to make sure the interface is the same.
 * 
 * @author P. Stegall 
 * @date Jan. 2022
*/

#ifndef Controller_h
#define Controller_h

//Arduino compiles everything in the src folder even if not included so it causes and error for the nano if this is not included.
#if defined(ARDUINO_TEENSY36)  || defined(ARDUINO_TEENSY41)

#include <Arduino.h>

#include "ExoData.h"
#include "Board.h"
#include "ParseIni.h"
#include <stdint.h>
#include "Utilities.h"
#include "config.h"
#include "Time_Helper.h"
#include <algorithm>
#include <utility>

#include <Adafruit_INA260.h>

/**
 * @brief This class defines the interface for controllers.  
 * All controllers must have a: float calc_motor_cmd() that returns a torque cmd in Nm.  
 * 
 */
class _Controller
{
	public:
        /**
         * @brief Constructor 
         * 
         * @param id of the joint being used
         * @param pointer to the full ExoData instance
         */
        _Controller(config_defs::joint_id id, ExoData* exo_data);
		
        /**
         * @brief Virtual destructor is needed to make sure the correct destructor is called when the derived class is deleted.
         */
        virtual ~_Controller(){};
        
        /**
         * @brief Virtual function so that each controller must create a function that will calculate the motor command
         * 
         * @return Torque in Nm.
         */
		virtual float calc_motor_cmd() = 0; 
        
        /**
         * @brief Resets the integral sum for the controller
         */
        void reset_integral(); 
        
    protected:
        
        ExoData* _data;                     /**< Pointer to the full data instance*/
        ControllerData* _controller_data;   /**< Pointer to the data associated with this controller */
        SideData* _side_data;               /**< Pointer for the side data the controller is associated with */
        JointData* _joint_data;             /**< Pointer to the joint data the controller is associated with */
         
        config_defs::joint_id _id;          /**< Id of the joint this controller is attached to. */
        
        Time_Helper* _t_helper;             /**< Instance of the time helper to track when things happen used to check if we have a set time for the PID */
        float _t_helper_context;            /**< Store the context for the timer helper */
        float _t_helper_delta_t;            /**< Time time since the last event */

        //Values for the PID controller
        float _pid_error_sum = 0;           /**< Summed error term for calucating intergral term */
        float _prev_input;                  /**< Prev error term for calculating derivative */
        float _prev_de_dt;                  /**< Prev error derivative used if the timestep is not good*/
        float _prev_pid_time;               /**< Prev time the PID was called */

        float _sim_gait_context = 0.0f;     /**< Timer context for simulated gait */
        float _sim_elapsed_us = 0.0f;       /**< Accumulated simulated time */
        		
        /**
         * @brief Calculates the current PID contribution to the motor command. 
         * 
         * @param controller command 
         * @param measured controlled value
         * @param proportional gain
         * @param integral gain
         * @param derivative gain
         */
        float _pid(float cmd, float measurement, float p_gain, float i_gain, float d_gain);

        /**
         * @brief Returns percent gait, optionally using a simulated 1-second cycle.
         *
         * @param simulate flag to use simulated percent gait
         */
        float _get_percent_gait(bool simulate);
		
		/**
         * @brief A function that returns cmd_ff for stateless PJMC. 
         * 
         * @param current fsr percentage value (after calibration, this value should typical range from 0 to 1 
         * @param fsr threshold; a current fsr value below this threshold will have the generic pjmc function return a cmd_ff with a sign of setpoint_negative
         * @param positive setpoint (the sign definitions follow those as shown in OpenSim's default models: Positive for dorsiflexion, knee extension, and hip flexion.
         * @param negative setpoint
         */
        float _pjmc_generic(float current_fsr, float fsr_threshold, float setpoint_positive, float setpoint_negative);
        
        //Values for the Compact Form Model Free Adaptive Controller
        std::pair<float, float> measurements;
        std::pair<float, float> outputs;
        std::pair<float, float> phi;            /**< Psuedo partial derivative */
        float rho;                              /**< Penalty factor (0,1) */
        float lamda;                            /**< Weighting factor limits delta u */
        float etta;                             /**< Step size constant (0, 1] */
        float mu;                               /**< Weighting factor that limits the variance of u */
        float upsilon;                          /**< A sufficiently small integer ~10^-5 */
        float phi_1;                            /**< Initial/reset condition for estimation of psuedo partial derivitave */
        
        float _cf_mfac(float reference, float current_measurement);
};

/**
 * @brief Terrain Responsive Exoskeleton Controller (TREC)
 * This controller is for the ankle joint
 *
 * For full details see: "Mixed Terrain Ankle Assistance and Modularity in Wearable Robotics" by Chancelor Frank Cuddeback (https://biomech.nau.edu/)
 *
 * See ControllerData.h for details on the parameters used.
 */
class TREC : public _Controller
{
public:
    TREC(config_defs::joint_id id, ExoData* exo_data);
    ~TREC() {};

    float calc_motor_cmd();

private:
    void _update_reference_angles(SideData* side_data, ControllerData* controller_data, float percent_grf, float percent_grf_heel);
    void _capture_neutral_angle(SideData* side_data, ControllerData* controller_data);
    void _grf_threshold_dynamic_tuner(SideData* side_data, ControllerData* controller_data, float threshold, float percent_grf_heel);
    void _plantar_setpoint_adjuster(SideData* side_data, ControllerData* controller_data, float pjmcSpringDamper);
};

/**
 * @brief Proportional Joint Moment Controller
 * This controller is for the ankle joint 
 * Applies a plantar torque based on the normalized magnitude of the toe FSR.
 * 
 * This controller is based on:
 * Gasparri, G.M., Luque, J., Lerner, Z.F. (2019).
 * Proportional Joint-Moment Control for Instantaneosuly Adaptive Ankle Exoskeleton Assistnace. IEEE TNSRE, 27(4), 751-759.
 *
 * See ControllerData.h for details on the parameters used.
 */
class ProportionalJointMoment : public _Controller
{
    public:
        ProportionalJointMoment(config_defs::joint_id id, ExoData* exo_data);
        ~ProportionalJointMoment(){};
        
        float calc_motor_cmd();
    private:
        std::pair<float, float> _stance_thresholds_left, _stance_thresholds_right;
        
        float _inclination_scaling{1.0f};
};


/**
 * @brief Zero Torque Controller
 * This controller is for the any joint
 * Simply applies zero torque
 * 
 * See ControllerData.h for details on the parameters used.
 */
class ZeroTorque : public _Controller
{
    public:
        ZeroTorque(config_defs::joint_id id, ExoData* exo_data);
        ~ZeroTorque(){};
        
        float calc_motor_cmd();
};

/**
 * @brief Zhang Collins Controller
 * This controller is for the ankle joint 
 * Applies ramp between t0 and t1 to (t1, ts).
 * From t1 to t2 applies a spline going up to (t2,mass*normalized_peak_torque).
 * From t2 to t3 falls to (t3, ts)
 * From t3 to 100% applies zero torque
 * 
 * This controller is based on:
 * Zhang, J., Fiers, P., Witte, K. A., Jackson, R. W., Poggensee, K. L., Atkeson, C. G., & Collins, S. H. 
 * (2017). Human-in-the-loop optimization of exoskeleton assistance during walking. Science, 356(6344), 1280-1284.
 * 
 * See ControllerData.h for details on the parameters used.
 */
class ZhangCollins: public _Controller
{
    public:
        ZhangCollins(config_defs::joint_id id, ExoData* exo_data);
        ~ZhangCollins(){};
        
        float calc_motor_cmd();

        float _spline_generation(float node1, float node2, float node3, float torque_magnitude, float percent_gait);

        float torque_cmd;
		float cmd;
};

/**
 * @brief Spline Controller
 * This controller is for the hip and ankle joints
 * Applies a spline curve defined by five (percent gait, torque) nodes.
 *
 * See ControllerData.h for details on the parameters used.
 */
class Spline: public _Controller
{
    public:
        Spline(config_defs::joint_id id, ExoData* exo_data);
        ~Spline(){};

        float calc_motor_cmd();

    private:
        float _spline_interpolate(const float* x, const float* y, float percent_gait);
};

/**
 * @brief Franks Collins Controller
 * This controller is for the Hip Joint
 *
 * Is 0 between t0_trough and t1_trough to (t1, 0).
 * From t1_trough to t2_trough applies a spline going down to (t2_trough,mass*normalized_trough_torque).
 * From t2_trough to t3_trough rises to (t3_trough, 0)
 * From t3_trough to t1_peak applies zero torque
 * From t1_peak to t2_peak applies a spline going up to (t2_peak,mass*normalized_peak_torque).
 * From t2_peak to t3_peak falls to (t3_peak, 0)
 *
 * This controller was based on:
 * Franks, P. W., Bryan, G. M., Martin, R. M., Reyes, R., Lakmazaheri, A. C., & Collins, S. H.
 * (2021). Comparing optimized exoskeleton assistance of the hip, knee, and ankle in single and multi-joint configurations. Wearable Technologies, 2.
 *
 * See ControllerData.h for details on the parameters used.
 */
class FranksCollinsHip: public _Controller
{
    public:
        FranksCollinsHip(config_defs::joint_id id, ExoData* exo_data);
        ~FranksCollinsHip(){};
       
        float calc_motor_cmd();

        float _spline_generation(float node1, float node2, float node3, float torque_magnitude, float shifted_percent_gait);

        float last_percent_gait;
        float last_start_time;
       
};

/**
 * @brief Constant Torque Controller
 * This controller is for any joint
 * Applies a constant torque, filter applied when changing magnitude of torque
 *
 * See ControllerData.h for details on the parameters used.
 */
class ConstantTorque : public _Controller
{
public:
    ConstantTorque(config_defs::joint_id id, ExoData* exo_data);
    ~ConstantTorque() {};

    float calc_motor_cmd();

    float previous_command;         /* Stores Previous Loop's Torque Command */
    float previous_torque_reading;  /* Stores Previous Loop's Measured Torque */
    int flag;                       /* Flag that Determines Filter Status */
    float difference;               /* Stores Difference in Command when Changed */

};

/**
 * @brief Elbow Controller 
 * This controller is for the elbow joint
 * Applies flexion or extension torque based on hand FSRs that assists with lifting motion 
 * 
 * This controller is detailed in:
 * Colley, D., Bowersock, C.D., Lerner, Z.F. (2024)
 * A Lightweight Powered Elbow Exoskeleton for Manual Handling Tasks. IEEE T-MRB, 6(4), 1627-1636.
 *
 * See ControllerData.h for details on the parameters used.
 */
class ElbowMinMax : public _Controller
{
public:
    ElbowMinMax(config_defs::joint_id id, ExoData* exo_data);
    ~ElbowMinMax() {};

    float alpha0;
    float alpha1;
    float alpha2;
    float alpha3;

    float cmd;

    float Smoothed_Sig_Flex;
    float Smoothed_Sig_Ext;
    float Smoothed_Flex_Max;
    float Smoothed_Flex_Min;
    float Smoothed_Ext_Max;
    float Smoothed_Ext_Min;

    float starttime;

    float check;

    float Angle_Max;
    float Angle_Min;
    float Angle;

    bool flexState;
    bool extState;
    bool nullState;

    float previous_setpoint;

    float fsr_toe_previous_elbow;
    float fsr_heel_previous_elbow;

    float SpringEffect;

    float calc_motor_cmd();
    
};

/**
 * @brief Calibration Controller
 * This controller is for any joint.
 * Applies a constant torque to help calibrate direction sign (+/-) and ensure torque sensor sign (+/-) matches desired direction.
 * This controller should be utilized when first testing a new device, especially when incorporating a torque sensor.
 * Failure to do so can lead to amplification of error between desired and measured torque which can be unsafe. 
 *
 * See ControllerData.h for details on the parameters used. See documentation on procedures for calibration
 */
class CalibrManager : public _Controller
{
public:
    CalibrManager(config_defs::joint_id id, ExoData* exo_data);
    ~CalibrManager() {};

    float calc_motor_cmd();
};

/**
 * @brief Chirp Controller
 * This controller is for any joint
 * Applies a sinewave with user defined parameters. 
 * Used for hardware performance validation. 
 *
 * See ControllerData.h for details on the parameters used.
 */
class Chirp : public _Controller
{
public:
    Chirp(config_defs::joint_id id, ExoData* exo_data);
    ~Chirp() {};

    float start_flag;               /* Flag that triggers recording of the initial start time of the controller upon usage. */
    float start_time;               /* Variable that stores the start time of the controller. */
    float current_time;             /* Variable that stores the current time of the controller. */
    float previous_amplitude;       /* Variable that stores the previous amplitude, used as a switch to restart the controller if needed. (Set amplitude to 0 and then set to desired amplitude). */

    float calc_motor_cmd();         /* Function that calculates the motor command. */

};

/**
 * @brief Step Controller
 * This controller is for any joint
 * Applies step response to hardware of user specified magnitude, duration, and frequency.
 * Used for hardware performance validation.
 *
 * See ControllerData.h for details on the parameters used.
 */
class Step : public _Controller
{
public:
    Step(config_defs::joint_id id, ExoData* exo_data);
    ~Step() {};

    int n;                          /* Keeps track of how many steps have been performed. */
    int start_flag;                 /* Flag that triggers the recording of the time that the step is first applied. */
    float start_time;               /* Time that the step was first applied. */
    float cmd_ff;                   /* Motor command. */
    float previous_time;            /* Stores time from previous iteration. */
    float end_time;                 /* Records time that step ended. */

    float previous_command;
    float previous_torque_reading;
    int flag;
    float difference;
    float turn;
    float flag_time;
    float change_time;

    float calc_motor_cmd();         /* Function that calculates the motor command. */

};

/**
 * @brief Proportional Hip Moment Controller
 * This controller is for the hip joint
 * Applies a torque based on an estimate of the hip moment.
 *
 * NOTE: THIS CONTROLLER IS STILL UNDERDEVELOPMENT
 * 
 * See ControllerData.h for details on the parameters used.
 */
class ProportionalHipMoment : public _Controller
{
public:
    ProportionalHipMoment(config_defs::joint_id id, ExoData* exo_data);
    ~ProportionalHipMoment() {};
    
    /* Note: Duration in this controller is in terms of number of iterations in that window, rather than as a time. */

    int state;                      /* Keeps track of what state we are in: State 1 - Mid-to-Late Swing (15% onward), State 2: Stance, State 3: Early-Swing (First 15%). */

    bool first_state2;              /* Flag to set variable values upon the first instance of the current State 2. */
    bool first_state3;              /* Flag to set variable values upon the first instance of the current State 3. */

    int swing_counter;              /* Keeps track of the number of iterations that have occured in current swing phase. */
    int state1_counter;             /* Keeps track of the number of iterations that have occured in current State 1. */
    int prev_state1_counter;        /* Stores the previous duration of State 1, used to estimate position in current State 1 relative to expected duration. */
    int stance_counter;             /* Keeps track of the number of iterations that have occured in current Stance Phase. */
    int swing_duration;             /* Stores the duration of the previous swing phase. */
 
    float setpoint;                 /* Stores the calculated feed-foward setpoint for the hip command. */
    float old_setpoint;             /* Stores the setpoint at the end of State 3 to be used for setpoint calculation in State 1. */

    int state_count_12;             /* Keeps track of the number of iterations that have occured in the State 1 - to - State 2 Transition. */
    int state_count_23;             /* Keeps track of the number of iterations that have occured in the State 2 - to - State 3 Transition. */
    int state_count_31;             /* Keeps track of the number of iterations that have occured in the State 3 - to - State 1 Transition. */
    
    int Prev_latestance_duration;   /* Stores the previous duration of the late-stance phase (part of the late-stance to early-swing transition period. */
    int latestance_duration;        /* Records the duration of the recently ended late-stance phase. */
    int latestance_counter;         /* Keeps track of the number of iterations that have occured in the current Late-Stance Period. */
    float Alpha_counter;            /* Keeps track of the number of iterations that have occured in the current Late-Stance - and - Early Swing Transition Period. */
    float Alpha;                    /* Stores the expected duration of the Late-Stance - and - Early Swing Transition Period, based on the duration of the last transition period. */
    float t;                        /* Calculated percentage of stance-to-swing transition based on the duration of the previous stance-to-swing transition (expressed as 0.1, 0.2,... rather than 10%, 20%,...). */
    
    float fs;                       /* Ratio of heel and toe fsrs accounting for GRF Ratio (0.25). */
    float fs_min;                   /* Stores the minimum calculated fs for the current cycle, used as a starting estimate for the Late-Stance - to - Early Swing transition period. */
    float prev_fs;                  /* Stores the previous cycle's fs to help determine the slope of the fs curve. */
    float hip_ratio;                /* Part of calculation to determine the feed-foward setpoint calculation during stance-phase (State 2). */

    float calc_motor_cmd();         /* Function to calcualte the desired motor command. */

private:

};

/**
 * @brief SPV2 Controller
 * 
 * NOTE: THIS CONTROLLER IS STILL UNDER DEVELOPMENT 
 * 
 * See ControllerData.h for details on the parameters used.
 */
class SPV2 : public _Controller
{
public:
    SPV2(config_defs::joint_id id, ExoData* exo_data);
    ~SPV2() {};
	Adafruit_INA260 ina260 = Adafruit_INA260();

    float calc_motor_cmd();

private:
	void SPV2::_plantar_setpoint_adjuster(SideData* side_data, ControllerData* controller_data, float currentPrescription);
	void SPV2::_stiffness_adjustment(uint8_t minAngle, uint8_t maxAngle, ControllerData* controller_data);
	void SPV2::_calc_motor_current(ControllerData* controller_data);
	void SPV2::_step_counter(uint16_t num_steps_threshold, SideData* side_data, ControllerData* controller_data);
	void SPV2::_golden_search_advance();
	void SPV2::optimizer_reset();
	void SPV2::_SA_point_gen(float step_size, long bound_l, long bound_u, float temp);
	void SPV2::_lab_OP_point_gen(float step_size, long bound_l, long bound_u);
	
	//from TREC
	void _update_reference_angles(SideData* side_data, ControllerData* controller_data, float percent_grf, float percent_grf_heel);
    void _capture_neutral_angle(SideData* side_data, ControllerData* controller_data);
    void _grf_threshold_dynamic_tuner(SideData* side_data, ControllerData* controller_data, float threshold, float percent_grf_heel);
    //void _plantar_setpoint_adjuster(SideData* side_data, ControllerData* controller_data, float pjmcSpringDamper);
};

/**
 * @brief PJMC_PLUS Controller
 * 
 * NOTE: THIS CONTROLLER IS STILL UNDER DEVELOPMENT 
 * 
 * See ControllerData.h for details on the parameters used.
 */
class PJMC_PLUS : public _Controller
{
public:
    PJMC_PLUS(config_defs::joint_id id, ExoData* exo_data);
    ~PJMC_PLUS() {};

    float calc_motor_cmd();

private:

};

/**
 * @brief FSRless controller
 * This controller is for the Hip Joint
 *
 * See ControllerData.h for details on the parameters used.
 */
class FSRless: public _Controller
{
    public:
        FSRless(config_defs::joint_id id, ExoData* exo_data);
        ~FSRless(){};
       
        float calc_motor_cmd();
        
    private:
        void FSRless::calibrate_encoders();
        void FSRless::normalize_angle();
        void FSRless::normalize_vel();
        void FSRless::normalize_acc();
        void FSRless::calc_norms();

        bool first_loop;
        bool second_loop;
        long long_dt;

        float dt;

        float encoder_angle;
        float encoder_offset;
        float encoder_offset_0;
        float prev_encoder_angle;
        float norm_angle;
        float prev_norm_angle;
        float max_angle;
        float min_angle;

        float encoder_vel;
        float prev_encoder_vel;
        float norm_vel;
        float prev_norm_vel;
        float max_vel;
        float min_vel;

        float encoder_acc;
        float prev_encoder_acc;
        float norm_acc;
        float max_acc;
        float min_acc;

        unsigned long prev_time;

        unsigned long start_controller_time;

        float angle_setpoint;
        bool is_flexion;

        unsigned long last_switch;


       
};

#endif
#endif
