naubiomech/OpenExo/ExoCode/src/ParseIni.cpp

#include "ParseIni.h"
#include "Logger.h"
#include <stdlib.h> 

//We only need to parse the INI file if we have access to the SD card.
//The nano will get the info through SPI so doesn't need these functions.
#if defined(ARDUINO_TEENSY36)  || defined(ARDUINO_TEENSY41) 
    void ini_print_error_message(uint8_t e, bool eol = true)
    {
        if(Serial)
        {
            switch (e) {
            case IniFile::errorNoError:
                logger::print("no error");
                break;
            case IniFile::errorFileNotFound:
                logger::print("file not found");
                break;
            case IniFile::errorFileNotOpen:
                logger::print("file not open");
                break;
            case IniFile::errorBufferTooSmall:
                logger::print("buffer too small");
                break;
            case IniFile::errorSeekError:
                logger::print("seek error");
                break;
            case IniFile::errorSectionNotFound:
                logger::print("section not found");
                break;
            case IniFile::errorKeyNotFound:
                logger::print("key not found");
                break;
            case IniFile::errorEndOfFile:
                logger::print("end of file");
                break;
            case IniFile::errorUnknownError:
                logger::print("unknown error");
                break;
            default:
                logger::print("unknown error value");
                break;
            }
            if (eol)
            {
                logger::print("\n");
            }
        }
    }


    void ini_parser(uint8_t* config_to_send)
    {
        ini_parser("/config.ini", config_to_send);   
    }


    void ini_parser(char* filename, uint8_t* config_to_send)
    {
        ConfigData data;  //Creates object to hold the key values

        //Set pin to select the SD card
        pinMode(SD_SELECT, OUTPUT);
        digitalWrite(SD_SELECT, HIGH); //Disable SD card

        //Create buffer to hold the data read from the file
        const size_t buffer_len = ini_config::buffer_length;
        char buffer[buffer_len];

        //Setup the SPI to read the SD card
        SPI.begin();

        if (!SD.begin(SD_SELECT))
        {
                while (1)
                
                if (Serial)
                {
                    logger::print("SD.begin() failed");
                    logger::print("\n");
                }
        }

        //Check the for the ini file
        IniFile ini(filename);

        if (!ini.open()) 
        {
            if(Serial)
            {
                logger::print("Ini file ");
                logger::print(filename);
                logger::print(" does not exist");
                logger::print("\n");
            }
            
            //Cannot do anything else
            while (1);
        }

        if(Serial)
        {
            logger::print("Ini file exists");
            logger::print("\n");
        }

        //Check the file is valid. This can be used to warn if any lines are longer than the buffer.
        if (!ini.validate(buffer, buffer_len))
        {
            if(Serial)
            {
                logger::print("ini file ");
                logger::print(ini.getFilename());
                logger::print(" not valid: ");
                ini_print_error_message(ini.getError());
            }

            //Cannot do anything else
            while (1);
        }
          
        get_section_key(ini,"Board","name",buffer,buffer_len); //Read the key.
        data.board_name = buffer;                              //Store the value
        
        // logger::print(data.board_name.c_str());
        // logger::print("\t");
        // logger::println(config_map::board_name[data.board_name]);

        config_to_send[config_defs::board_name_idx] = config_map::board_name[data.board_name];  //Encode the key to an uint8_t
        
        get_section_key(ini,"Board","version",buffer,buffer_len);
        data.board_version = buffer;

        // logger::print(data.board_version.c_str());
        // logger::print("\t");
        // logger::println(config_map::board_version[data.board_version]);

        config_to_send[config_defs::board_version_idx] = config_map::board_version[data.board_version];
        
        //=========================================================
        
        get_section_key(ini,"Battery","name",buffer,buffer_len);
        data.battery = buffer;

        // logger::print(data.board_version.c_str());
        // logger::print("\t");
        // logger::println(config_map::board_version[data.board_version]);

        config_to_send[config_defs::battery_idx] = config_map::battery[data.battery];
        
        //=========================================================
        
        get_section_key(ini,"Exo","name",buffer,buffer_len);
        data.exo_name = buffer;

        // logger::print(data.exo_name.c_str());
        // logger::print("\t");
        // logger::println(config_map::exo_name[data.exo_name]);

        config_to_send[config_defs::exo_name_idx] = config_map::exo_name[data.exo_name];
        
        //=========================================================
        // Read all exoskeleton configuration keys directly from the [Exo] section.
        // [Exo] name is still used as an exo type selector for comms/packet format.
        get_section_key(ini,"Exo","sides",buffer,buffer_len); 
        data.exo_sides = buffer;
		
        // logger::print(data.exo_sides.c_str());
        // logger::print("\t");
        // logger::println(config_map::exo_side[data.exo_sides]);

        config_to_send[config_defs::exo_side_idx] = config_map::exo_side[data.exo_sides];
        
        //--------------------------------------------------------
        
        get_section_key(ini,"Exo","hip",buffer,buffer_len);
        data.exo_hip = buffer;

        // logger::print(data.exo_hip.c_str());
        // logger::print("\t");
        // logger::println(config_map::motor[data.exo_hip]);

        config_to_send[config_defs::hip_idx] = config_map::motor[data.exo_hip];
        
        get_section_key(ini,"Exo","knee",buffer,buffer_len);
        data.exo_knee = buffer;

        // logger::print(data.exo_knee.c_str());
        // logger::print("\t");
        // logger::println(config_map::motor[data.exo_knee]);
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
