naubiomech/OpenExo/(commit log)

2024-09-13 Updated Hardware section to include Large Cable Transmission System, Added in Publication Data
    [Back_Cover_AK60V1_1(1).SLDPRT, Bill_of_Materials_AK60V1_1.xlsx, Bill_of_Materials_AK70.xlsx, Bill_of_Materials_AK80.xlsx, Bill_of_Materials_Large_Cable.xlsx, Duration_Test_Results.xlsx, Exo_Metabolic.xlsx, Exo_Metabolics.csv]
2024-10-30 Fixed Default Controller Bug with Ankle and Elbow Configurations
    [Controller.cpp, ControllerData.h, ExoCode.ino, FSR.cpp, Joint.cpp, ParseIni.cpp, ParseIni.h, uart_commands.h]
2025-01-06 Updated GUI, Added Documentation on Adding Sensors, Added Heat Shield Designs
    [ak60v1_1HeatShield.SLDPRT, ak80HeatShield.SLDPRT, hipHeatShield.SLDPRT]
2025-01-09 Added Saftey Overview Document and Updated Publication Data with New Duration Test Data
    [Duration_Test_Results.xlsx]
2025-02-07 Integration of Maxon Motor Code, Addition of Indevelopment Control Schemes (PHJM, SPV2), Updated Commenting Throughout.
    [PHMC.csv, spv2.csv]
2025-03-01 Fixed Joint.cpp
    Fixed issue with compiling with the newest version of teensy (1.59)
    [Joint.cpp]
2025-03-21 Fixed Trial Switching and Added Pause/Play Closes #6 Closes #4
2025-06-12 Added a debug feature(Manual Motor Control)
2025-06-17 Updated all configurations to default to do nothing (value of 0) as a saftey precaution (so people have to change them to get the system to work and thus should have an idea of what is going on). Upd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
2025-06-18 Maxon dual-motor PCB fix ver0.8
    Contains hardcoded pin definitions
    [Board.h, Config.h, Motor.cpp]
2025-06-18 Maxon dual-motor PCB fix ver0.9
    All hardcoded pin definitions removed/fixed
    [Board.h, Motor.cpp, Motor.h]
2025-06-19 Maxon dual-motor PCB fix ver1
    Comments added
    [Motor.cpp, Motor.h]
2025-06-20 Bilateral fix and a new PJMC controller
    [pjmc_plus.csv]
2025-06-20 Reverted the default PCB version to 0.5.1 (AK motors)
    [Board.h, Config.h]
2025-06-20 Release 1.05 Fixed Button Loc.
2025-06-20 Fixed the "Debug button press enabling the Maxon motor" issue
    [Board.h, Motor.cpp]
2025-06-24 Fixed bug realted to constant torque controller and updated GUI pause/play feature to keep previous controller updates
    [Controller.cpp, Joint.cpp, Motor.cpp]
2025-06-24 Fixing plotting order, Debug mode, and pause/play button
    [Config.h, uart_commands.h]
2025-06-25 Updated Biofeedback to account for new plotting positions. Updated Config.ini with all controllers availabe for each joint.
    [elbowMinMax.csv]
2025-06-26 Updated Config.ini file with clearer instructions on where and when to set the board version (must be done in Config.h prior to flashing code to board).
2025-06-26 Updated Controller .csvs across all joints to match current implementation of control schemes. Changed default filtering term (for relevant controllers) to do no filtering.
    [chirp.csv, constantTorque.csv, step.csv, zeroTorque.csv]
2025-07-25 Calibration manager for hip
    Pending test
2025-07-25 Calibration manager for knee.
    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
2025-08-08 Calibration manager defined for hip and knee
2025-08-13 Fixed the ankle angle sensor and updated the SPV2 controller
    [AnkleAngles.cpp, AnkleAngles.h, Board.h, Config.h, Controller.cpp, Controller.h, ControllerData.h, Joint.cpp]
2025-08-13 Troubleshooting dual servo control
2025-08-13 Standardized servo motor control
2025-08-25 Removed deprecated servo control code (#12)
    * Removed deprecated servo control code
    * Revert to the generic plots
    [Controller.cpp, Controller.h]
2025-10-07 Removed publication folders
    [7804K143_Stainless Steel Ball Bearing.SLDPRT, 90236A127_M3x35_1Zinc-Plated Alloy Steel Torx Flat Head Screws.SLDPRT, 91290A117_M3x12_6Alloy Steel Socket Head Screw.SLDPRT, 92095A179_M3x6_1Button Head Hex Drive Screw.SLDPRT, 92095A181_M3x8_8Button Head Hex Drive Screw.SLDPRT, 92095A189_M4x8_6Button Head Hex Drive Screw.SLDPRT, 92334A109_M3_1Aluminum Washer.SLDPRT, 97763A813_M3x8_218-8 Stainless St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]
2025-10-07 Added battery collection and display, and mark resets at end of trial
2025-10-08 Battery voltage display
    To enable, set BATTERY_SENSOR in Config.h
2025-10-09 Enabled NullMotor type
    When this is set on the SD Card, the controller code will run for devices without a motor
2025-10-09 Enabled battery voltage detection for OpenExo Board 0.5.1 Mark 3
2025-10-14 Improved Calibration Manager
    SIMPLE_DEBUG is enabled by default. To disable, check Config.h.
2025-10-14 Removed non-functional battery code
    Commented out
2025-10-29 Disabled feedback ctrl when calibrate TRQ failed.
    Now _pid() outputs the desired value in case the torque sensor fails to calibrate.
    [Controller.cpp]
2025-10-30 Validated on-board voltage-divider sensing
    Fixed a typo that prevented the code from compiling
    [Config.h, Controller.cpp]
2026-01-21 Removed old, unused INA260 code. Resolved "jump to case label" issue in Exodata.h for the switch cases for the battery.
    [Config.h, Controller.h, ExoData.cpp]
2026-01-22 Updated board file to include servo pins for this board
2026-01-22 Created new board definition for AFO board
2026-01-22 Changed critical battery value for INA219 devices
2026-02-13 Add BLE updates and bug fixes - Updated BLE communication handling in ExoCode - Enhanced device scanning and connection management in GUI - Improved real-time bridge functionality - Fixed device mana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
    [Config.h, QtExoDeviceManager.py, RtBridge.py]
2026-04-01 Add comprehensive crash logging system to GUI
    Implemented full error logging throughout the application to track all crashes and exceptions. Added global exception hook, replaced 33 silent exception handlers with proper logging, and added auto-flushing for ERROR/CRITICAL messages. Logs saved to Python_GUI/Saved_Data/logs/ with timestamps.
    [QtExoDeviceManager.py, RtBridge.py]
2026-04-09 Added logo, fixed button labels
2026-04-10 shorten calibrate torque timeout
2026-04-21 updated/fixed CSV controller files for spline controller
    [spline.csv]
2026-04-21 fixed typo in step controllers
    [step.csv]
2026-04-21 fixed typos in controller .csv files
    [chirp.csv, constantTorque.csv]
2026-05-05 Major update: BLE bulk handshake, config-scoped params, GUI session handling
    Teensy/Nano: ListCtrlParams gates by config.ini, optional default-controller-only rows, GetBulkChar/Nano buffer + end marker, ExoBLE single handshake per connection, SendBulkChar diagnostics.
    Python GUI: RtBridge full value DB + reset on new link; MainWindow clears controller DB and saved prefs on session change; SettingsManager purges device controller keys; settings pages reset in-memory state.
    [ExoBLE.cpp, ExoBLE.h, GetBulkChar.cpp, GetBulkChar.h, ListCtrlParams.cpp, ListCtrlParams.h]
2026-05-07 (1) Fixes bug where only default controller values were being sent to GUI. (2) Fixes plotting labels. (3) Fixes step controller start on start trial flag.
    [Controller.cpp, GetBulkChar.cpp, GetBulkChar.h, ListCtrlParams.cpp, ListCtrlParams.h, PlottingTitles.cpp, PlottingTitles.h]
2026-05-08 Fixed Android App folder in repo
    [ActiveTrialScreen.kt, BleManager.kt, BleViewModel.kt]
2026-05-12 fixes iOS bug where last command was resent automatically on reconnection; changes Load Device label; fixes connect prior device bugs.
    [QtExoDeviceManager.py]
2026-06-10 created FSRless controller skeleton
    [FSRless.csv]
2026-06-10 initial ground work compiles
2026-06-11 changing logic because encoder_angle was not being updated
2026-06-15 serial printing/testing
2026-06-18 fsrless controller set up as mass spring damper model based on normalized angle, velocity, and acceleration (all normalized from raw encoder readings)
2026-06-23 spring damper with spring setpoint based on flexion or extension, setpoints and parameters are hard coded due to implementation error in setting up SD card
    [FSRless.csv]
